Mat-desau/S7_APP1/APP/01 - SCHEMAS ET PCB/99 - WORKING COPY/Project Outputs for S7CAS-PLEIADES-CARTE-MERE_P01/P01_S7PLEIADES_ALIM.PDF

V | I | V | I | V | I
24 V | 4,6425 A | 24 V | 8 mA | 24 V | 8 mA
V I
24 V | 4,6425 A
| | V | I | V | I
| | 24 V | 1,9 A | 24 V | 1,9 A
SWR | Eff: 50 % | LDO | Eff: 83% | V | I | V | I | V | I
| | | | 5V | 56,2 mA | 5 V | 12mA | 5 V | 44.2mA
Vin | Vout | Vin | Vout
24 V | 6 V | 6 V | 5 V
Iin | Iout | Iin | Iout
28,1 mA | 56,2 mA | 56,2 mA | 56,2 mA
Pin | Pout | Pin | Pout
0,67 W | 0,34 W | 0,34 W | 0,281 W
SWR | Eff: 70 % | LDO | Eff: 63% | V | I | V | I | V | I
| | | | -5V | 56,2 mA | 5 V | 12 mA | 5 V | 44,2 mA
Vin | Vout | Vin | Vout
24 V | -8 V | -8 V | -5 V
Iin | Iout | Iin | Iout
24,4 mA | 56,2 mA | 56,2 mA | 56,2 mA
Pin | Pout | Pin | Pout
0,59 W | 0,45 W | 0,45 W | 0,281 W
SWR | Eff: 85%
Vin 24 V | Vout 5 V
Iin 0,774 A | Iout 3,16 A
Pin | Pout | V | I | V | I | V | I | 3 | I | 3 | I
18,58 W | 15,8 W | 3,3 V | 50mA | 3,3 V | 5 mA | 3,3 V | 0,33mA | 3,3 V | 0,33mA | 3,3 V | 0,25 A
SWR | Eff: 95% | V | I | V | I | V | I | V | I | V | I | V | I
| | 3,3 V | 0,96966 A | 3,3 V | 100mA | 3,3 V | 500mA | 3,3 V | 47mA | 3,3 V | 2mA | 3,3 V | 15mA
Vin | Vout
5 V | 3,3 V
Iin 1,716 A | Iout 2,47 A
Pin 8,58 W | Pout 8,1551 W | V 3,3 V | I 0,1 A | V 3,3 V | I 0,1 A
V | I | V | I | V | I | V | I | V | I | V | I
3,3 V | 0,108 A | 3,3 V | 0,1 A | 3,3 V | 2 mA | 3,3 V | 2 mA | 3,3 V | 2 mA | 3,3 V | 2 mA
V | I | V | I | V | I | V | I
3,3 V | 4,334 mA | 3,3 V | 4 mA | 3,3 V | 0,165 mA | 3,3 V | 0,165 mA
V | I | V | I
3,3 V | 0,05 A | 3,3 V | 0,05 A
LDO | Eff: 46 % | LDO | Eff: 50%
P.5 PFGA (DC switching) | p.40 Datasheet
Vin | Vout | Vin | Vout
3,3 V | 1,5V | 1,5 V | 0,75 V | V | I | V | I | V | I
Iin | Iout | Iin | Iout | 0,75 V | 41 uA | 0,75 | 40 uA | 0,75 | 1 uA
1,2477 A | 1,2477 A | 41 uA | 41 uA
Pin | Pout | Pin | Pout
4,11 | 1,872 W | 61,5 uW | 30,75 uW
Vin | Vout
1,5 V | 0,75 V | V | I | V | I
Iin | Iout | 0,75 V | 0,4477 A | 0,75 V | 0,4477 A
0,4477 A | 0,4477 A
Pin | Pout
0,671 W | 0,335 W
V | I | V | I
1,5 V | 0,2 A | 1,5 V | 0,2 A
V | I | V | I
1,5 V | 0,3 A | 1,5 V | 0,3 A
LDO | Eff: 55% | V | I | V | I | V | I
| | 3,3 V | 0,376 A | 3,3 V | 56mA | 3,3 V | 320mA
Vin | Vout
5 V | 3,3 V
Iin 0,376 A | Iout 0,376 A
Pin 1.88 W | Pout 1,2408 W
SWR | Eff: 85% | V | I | V | I
| | 1,8 V | 0,05 A | 1,8 V | 0,05 A
Vin | Vout
5 V | 1,8 V
Iin 0,26 A | Iout 0,616 A
Pin 1,3041 W | Pout 1,1088 W | V 1,8 V | I 0,058 A | V 1,8 V | I 58mA
V | I | V | I | V | I
1,8 V | 0,508 A | 1,8 V | 343mA | 1,8 V | 165mA
SWR | Eff: 82 % | V | I | V | I
| | 1,2 V | 3A | 1,2 V | 3A
Vin | Vout
5 V | 1,2 V
Iin 0,818 A | Iout 3 A
Pin 4,09 W | Pout 3,6 W

5V

P
0,281 W

-5V

P
0,281 W

3V3_MOT

P
1,1022 W

FPGA

P
30,75 uW | 225 uW

Pdis
0,335 W

VCCO_2

P
0,3564 W

Pdis
23,25 uW

VREF0V75

P

0,336 W

P

VTT0V75

VCCO_1

24V
External
Power Supply

P
111,42 W

(U3) TPS51200DRCT

0,33W | 1,65W | 0,15W | 0,007W | 0,05W
P | P | P | P | P

D5 (DEL IO) (+TVS)

P
0,0066 W

D6 (DEL IO) (+TVS)

P

3,199 W

+24V

P
111,42 W

VCCO_0

0,0066 W

D3 (DEL IO) (+TVS)

P
0,0066 W

D4 (DEL IO) (+TVS)

P
0,0066 W

0,0165 W

Y2 (Clock Osillo) | U12 (Clock Buffer) | U5 (Ethernet PHY) | J2 (LED Ethernet) | Y1 (Oscilli Ethernet)
| | 0,001W | 0,001W

M1 (JTAG)

P
0,17W
S1 (Bouton RESET) | S2 (Bouton 1) | S3 (Bouton 2)
P | P | P

0,45 W

U8D (CAN)

Calcul DDR3 (fichier)

P
0.18W | 1,06W

0,22W

U1A (FPGA) (50%+)

P
0,33 W

U1C (FPGA) (50%+)

P

U1B (MOTEUR)(ALIM)

P
0,192 W

U1C (MOTEUR)(ALIM)

P
0,192 W

U1D (FPGA)(+50%)

P
0,45 W

U2 (DDR3)

P
0,3 W
U11 (Ampli-OP) (CNA) | U9 (Ampli-OP) (CAN)

P P
0,06 W | 0,22 W

0,33 W

U11 (Ampli-OP) (CNA)

P
0,06W

U9 (Ampli-OP) (CAN)

P

1V2

P

RES (40x24)(1,5V-0,75V)

P
0,335775 W

0,165 W

P
0,165 W

RES U10A (Vref)

P
0,0005445 W

U7C (CNA)

P
0,1W

U1E (FPGA)(-50%)

P
0,09 W
U7C (CNA) | U8D (CAN)

P P
0,6W | 0,3W

U10 (MotorDrive)

CLK_1V8

P

VCCO_4

P
0,09 W

Max current: 10 A

Pdis
2,688 W

U1I (VCC_AUX)

P
0,825 W

RES U10A (DECAY)

P
0,0005445 W

P
0,0132 W

U1B (FPGA)(-50%)

P

Max current: 10 A

VCC1V5

P
0,3 W

VCCO_3

P

90 et 85% environ

80% à 90% environ

(U18) LMZ34002

Max current: 2 A

(U19) NCP59744MN1ADJTBG

Max current: 3 A

Pdis
0.64 W

0,1953 W

Max current: 6 A

Pdis
0.429 W

(U17) PTH08T231W

Pdis
0,14 W

Max current: 6 A

Pdis

(U15) PTH08T231W

0,06 W

(U16) PTH08T241W

Max current: 10 A

Pdis
0,488 W

3,6 W

ANA_3V3 | U7C (CNA)

(U14) NCP59744MN1ADJTBG

Max current: 3 A

Pdis
2,24 W

3,6 W

0,1044 W

DIG_1V8

P
0,9144 W

P
0,33 W

3V3

P

P P
1,2408 W

DDR3

P
0,75 uW

PROTECTIONS

U1I (FPGA)

P

(U20) TPS7A33

Max current: 1 A

Pdis
0,17 W
MOTEUR 1 ALIM | MOTEUR 2 ALIM

P P
45,6 W | 45,6 W

(U22) LMZ23603

Max current: 3 A

Pdis
0,33 W

(U21) LMZ23610

(U25) TPS7A4701

Max current: 1 A

Pdis
