Mat-desau/S7_APP1/APP/01 - SCHEMAS ET PCB/99 - WORKING COPY/Project Outputs for S7CAS-PLEIADES-CARTE-MERE_P01/P01_S7PLEIADES_SCH.PDF

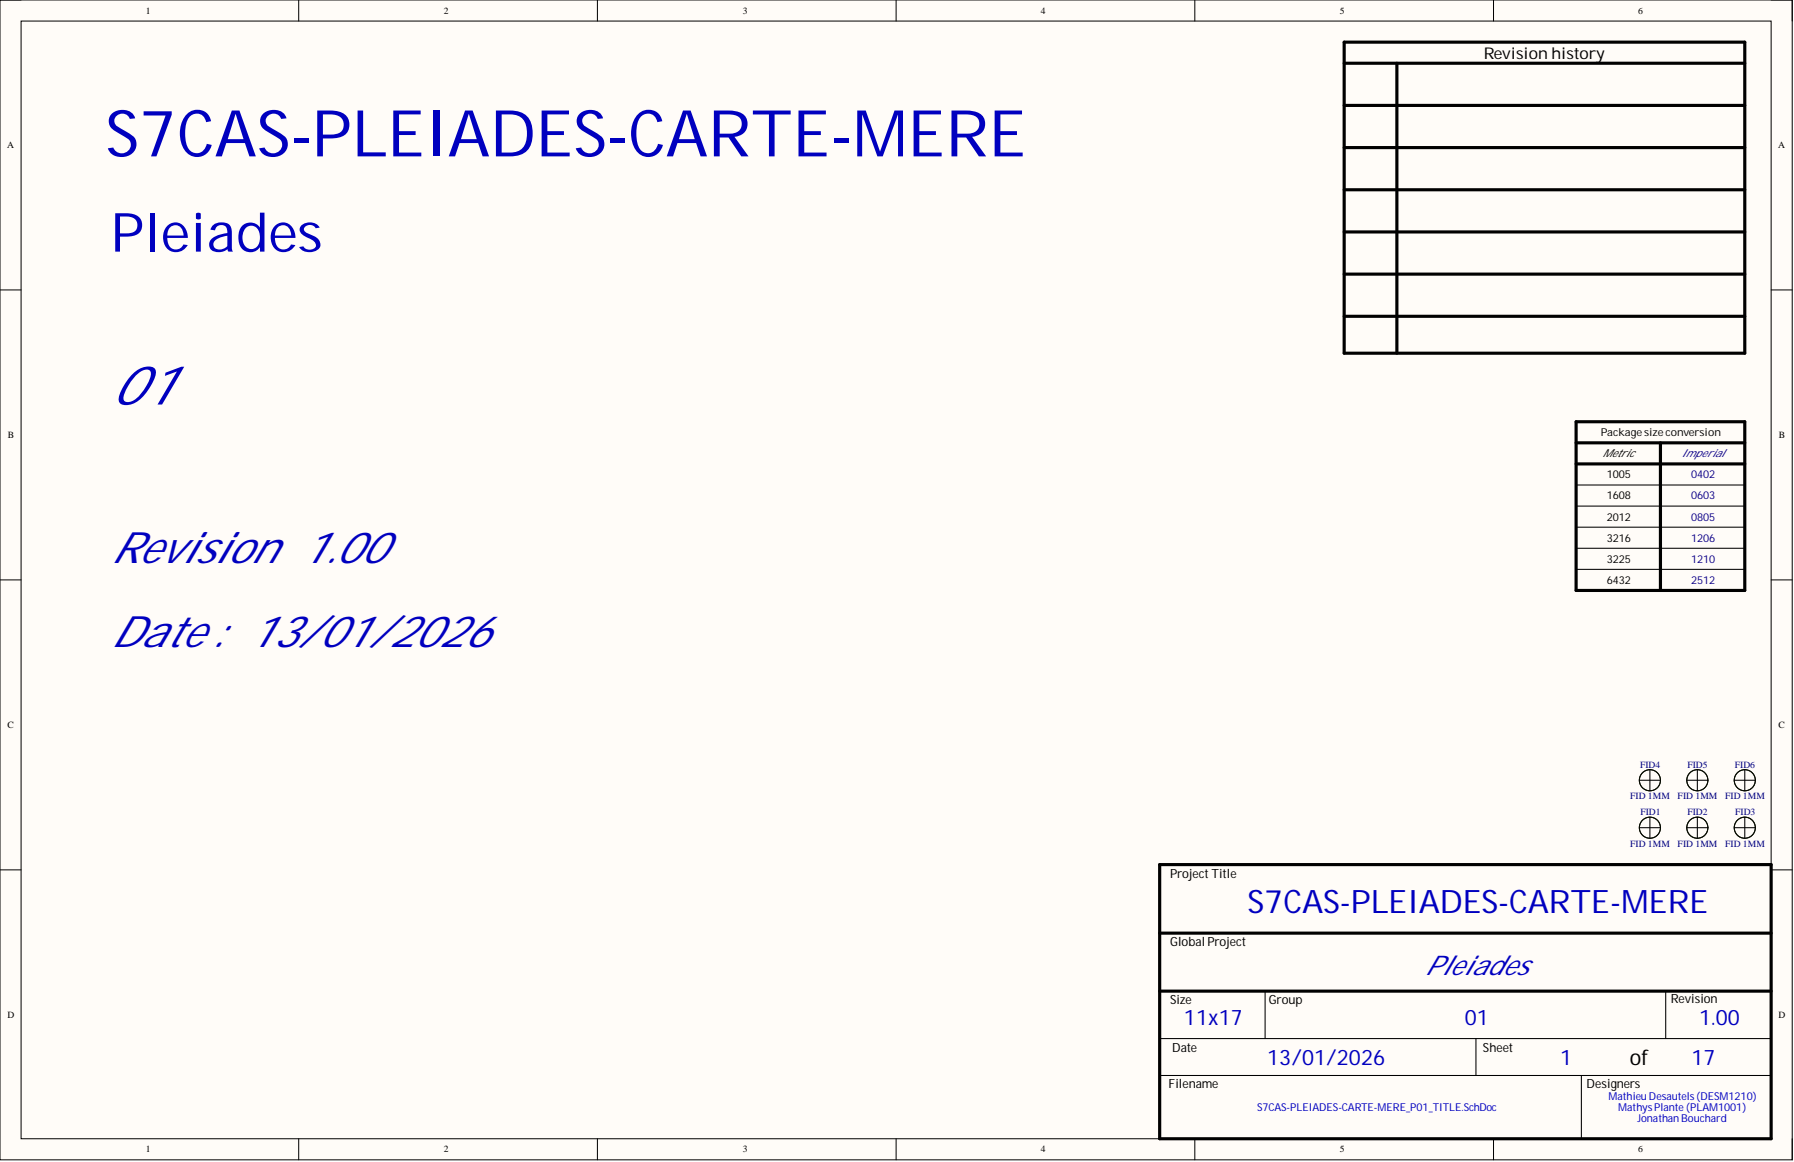
[picture p1: page 1]

Metric | Imperial

Size 11x17 | Group 01 | Revision 1.00

Date 13/01/2026 | Sheet 1 of 17

Filename S7CAS-PLEIADES-CARTE-MERE_P01_TITLE.SchDoc | Designers Mathieu Desautels (DESM1210) Mathys Plante (PLAM1001) Jonathan Bouchard

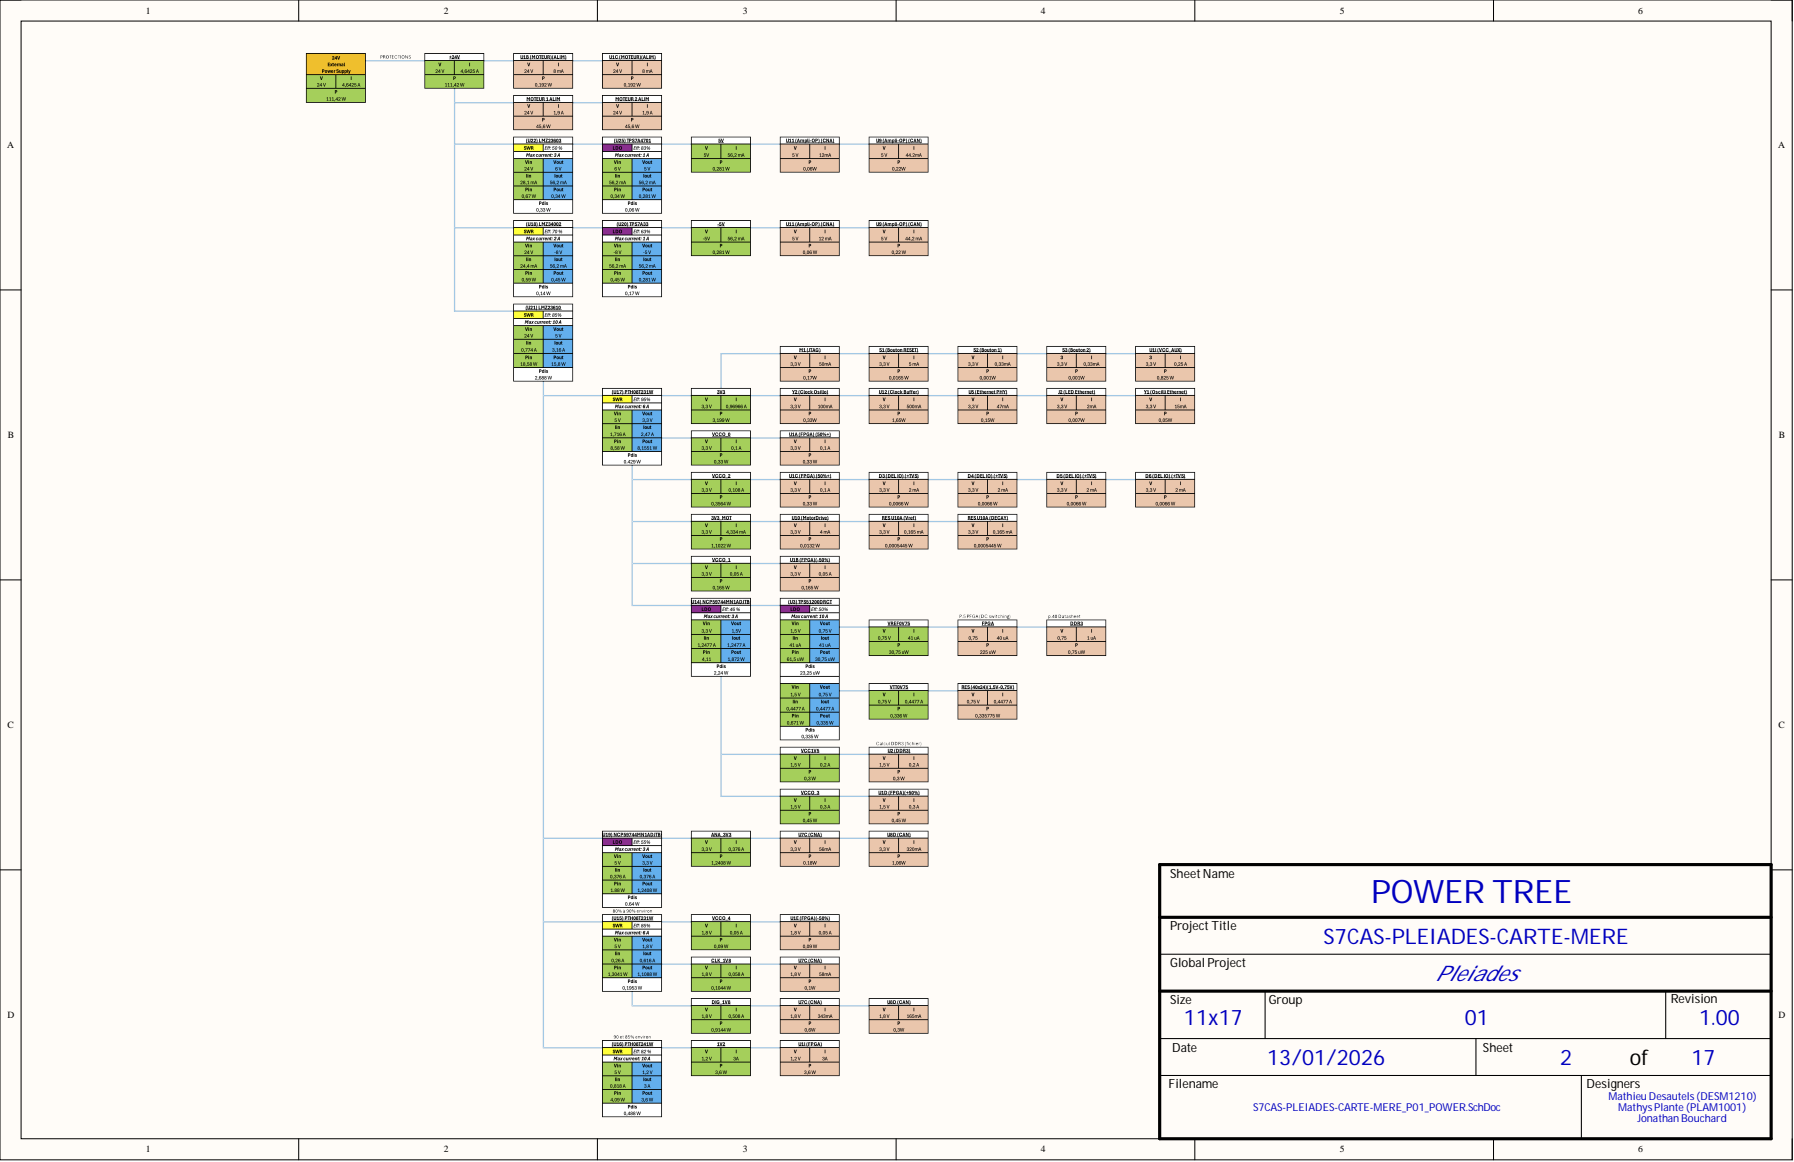
[picture p2: page 2]

Size 11x17 | Group 01 | Revision 1.00

Date 13/01/2026 | Sheet 2 of 17

S7CAS-PLEIADES-CARTE-MERE_P01_POWER.SchDoc | Mathieu Desautels (DESM1210)

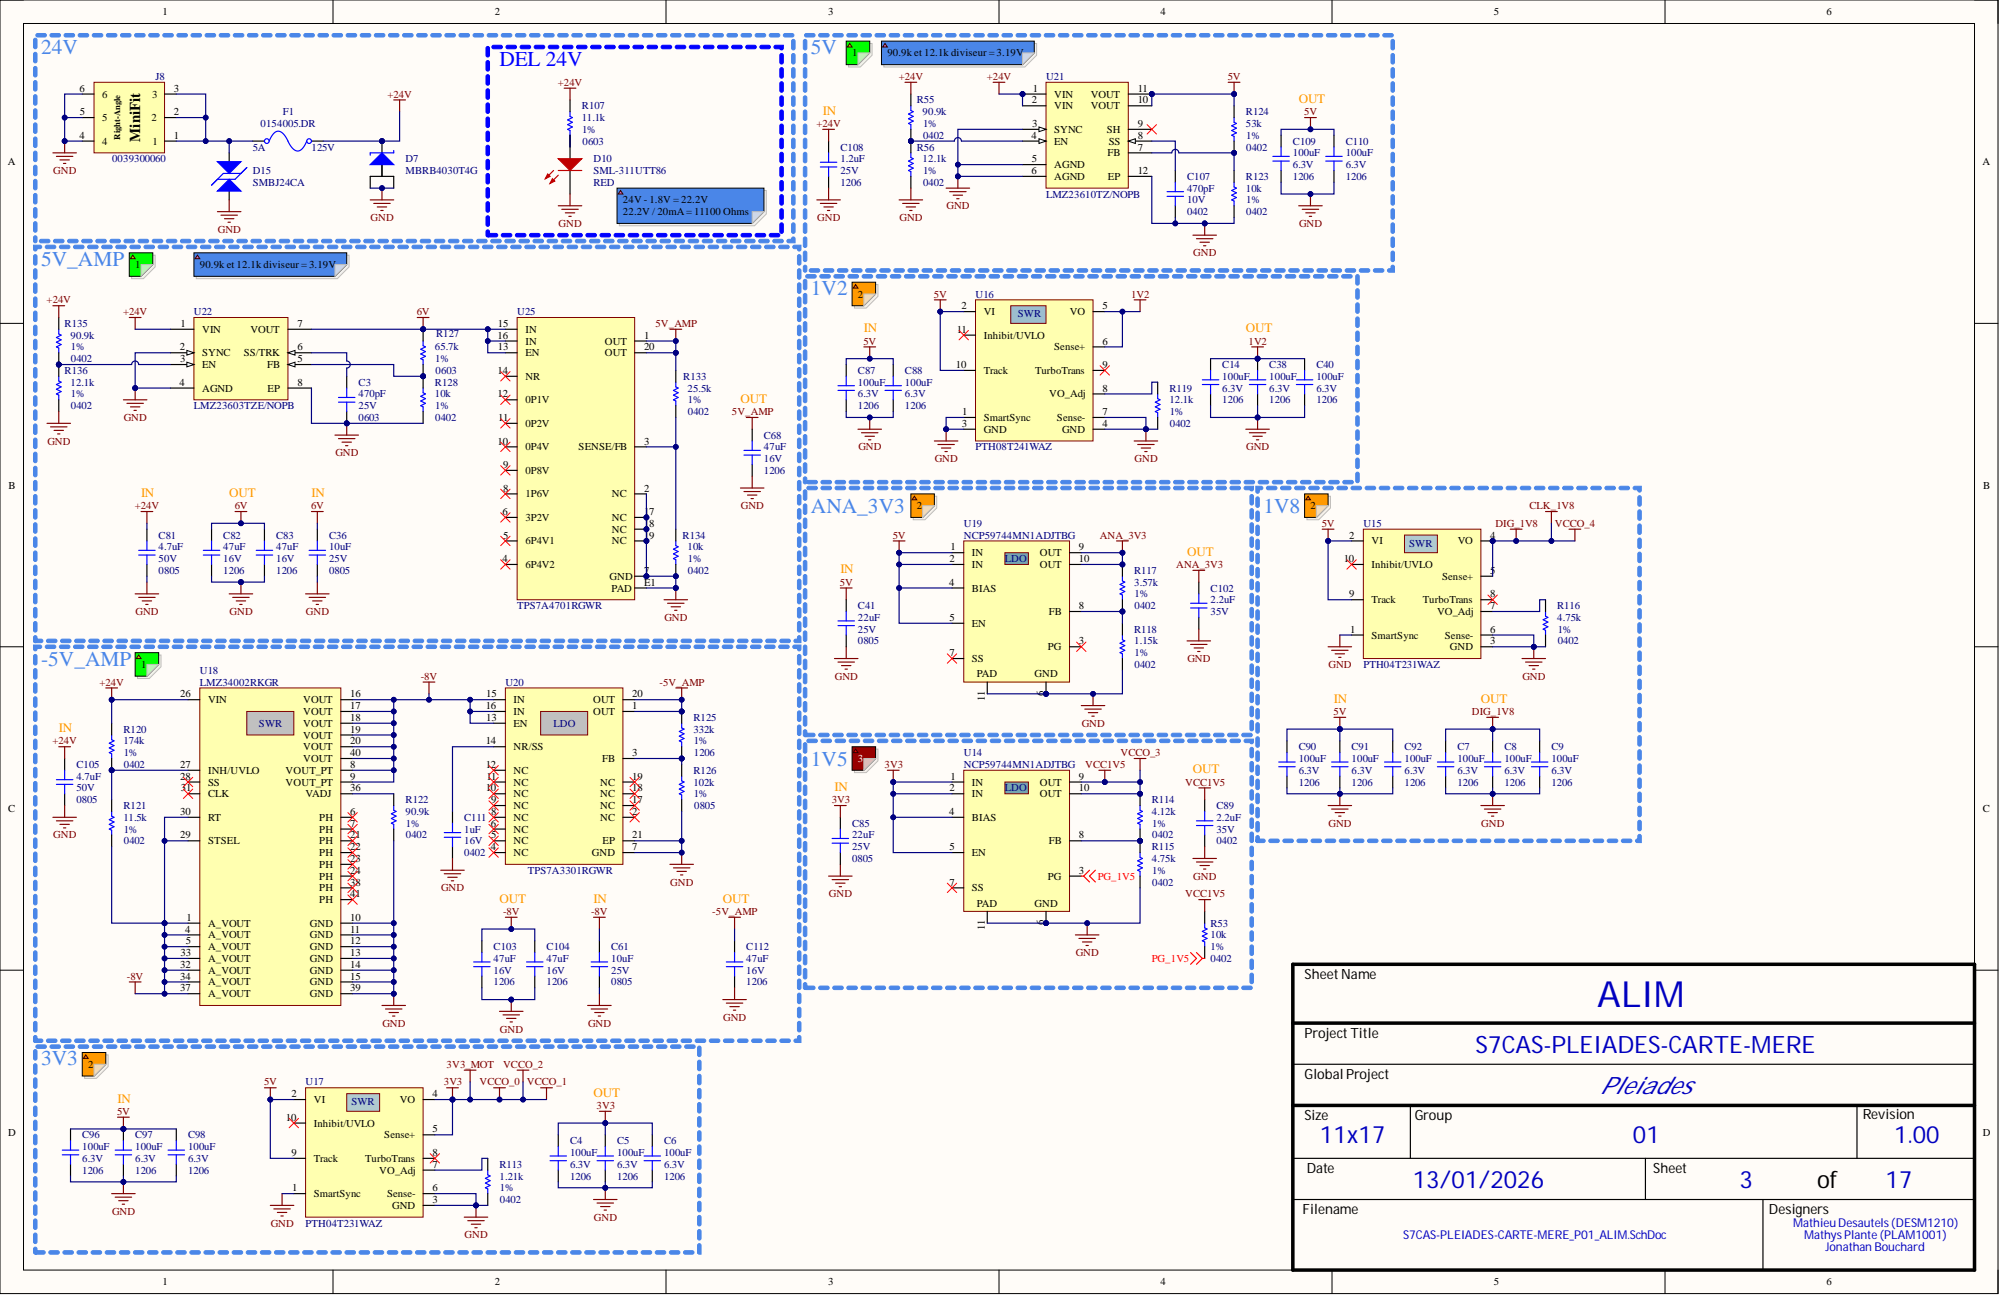
[picture p3: page 3]

AGND 5

Inhibit/UVLO 11

AGND 4

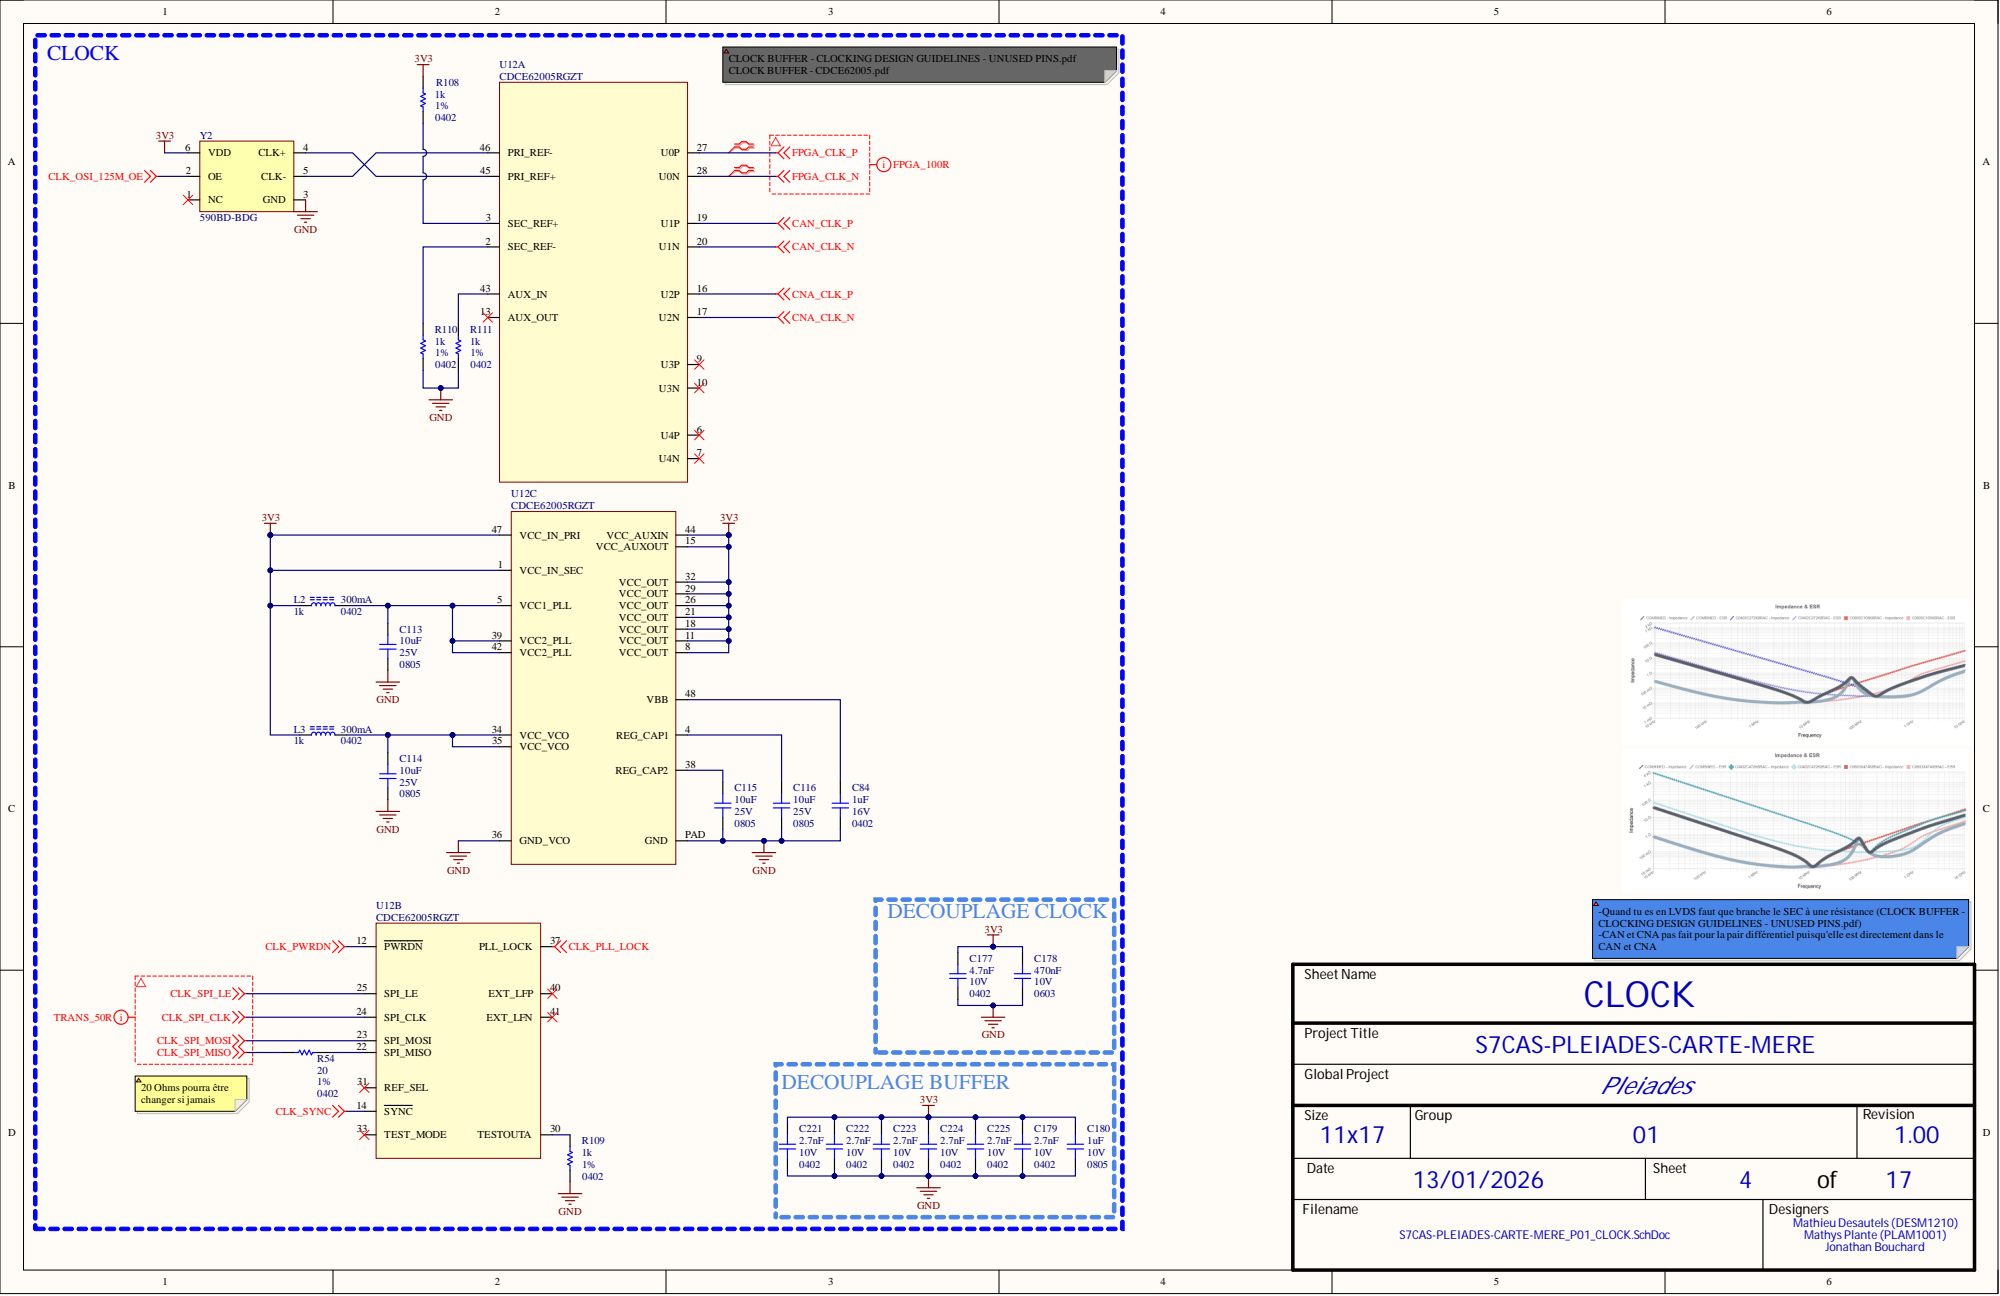
[picture p4: page 4]

CLOCK BUFFER - CLOCKING DESIGN GUIDELINES - UNUSED PINS.pdf
CLOCK BUFFER - CDCE62005.pdf

300mA | VCC1_PLL 5

VCC2_PLL 39

-Quand tu es en LVDS faut que branche le SEC à une résistance (CLOCK BUFFER -
CLOCKING DESIGN GUIDELINES - UNUSED PINS.pdf)
-CAN et CNA pas fait pour la pair différentiel puisqu'elle est directement dans le
CAN et CNA
CLOCK

Size 11x17 | Group 01 | Revision 1.00

Date 13/01/2026 | Sheet 4 of 17

S7CAS-PLEIADES-CARTE-MERE_P01_CLOCK.SchDoc | Mathieu Desautels (DESM1210)

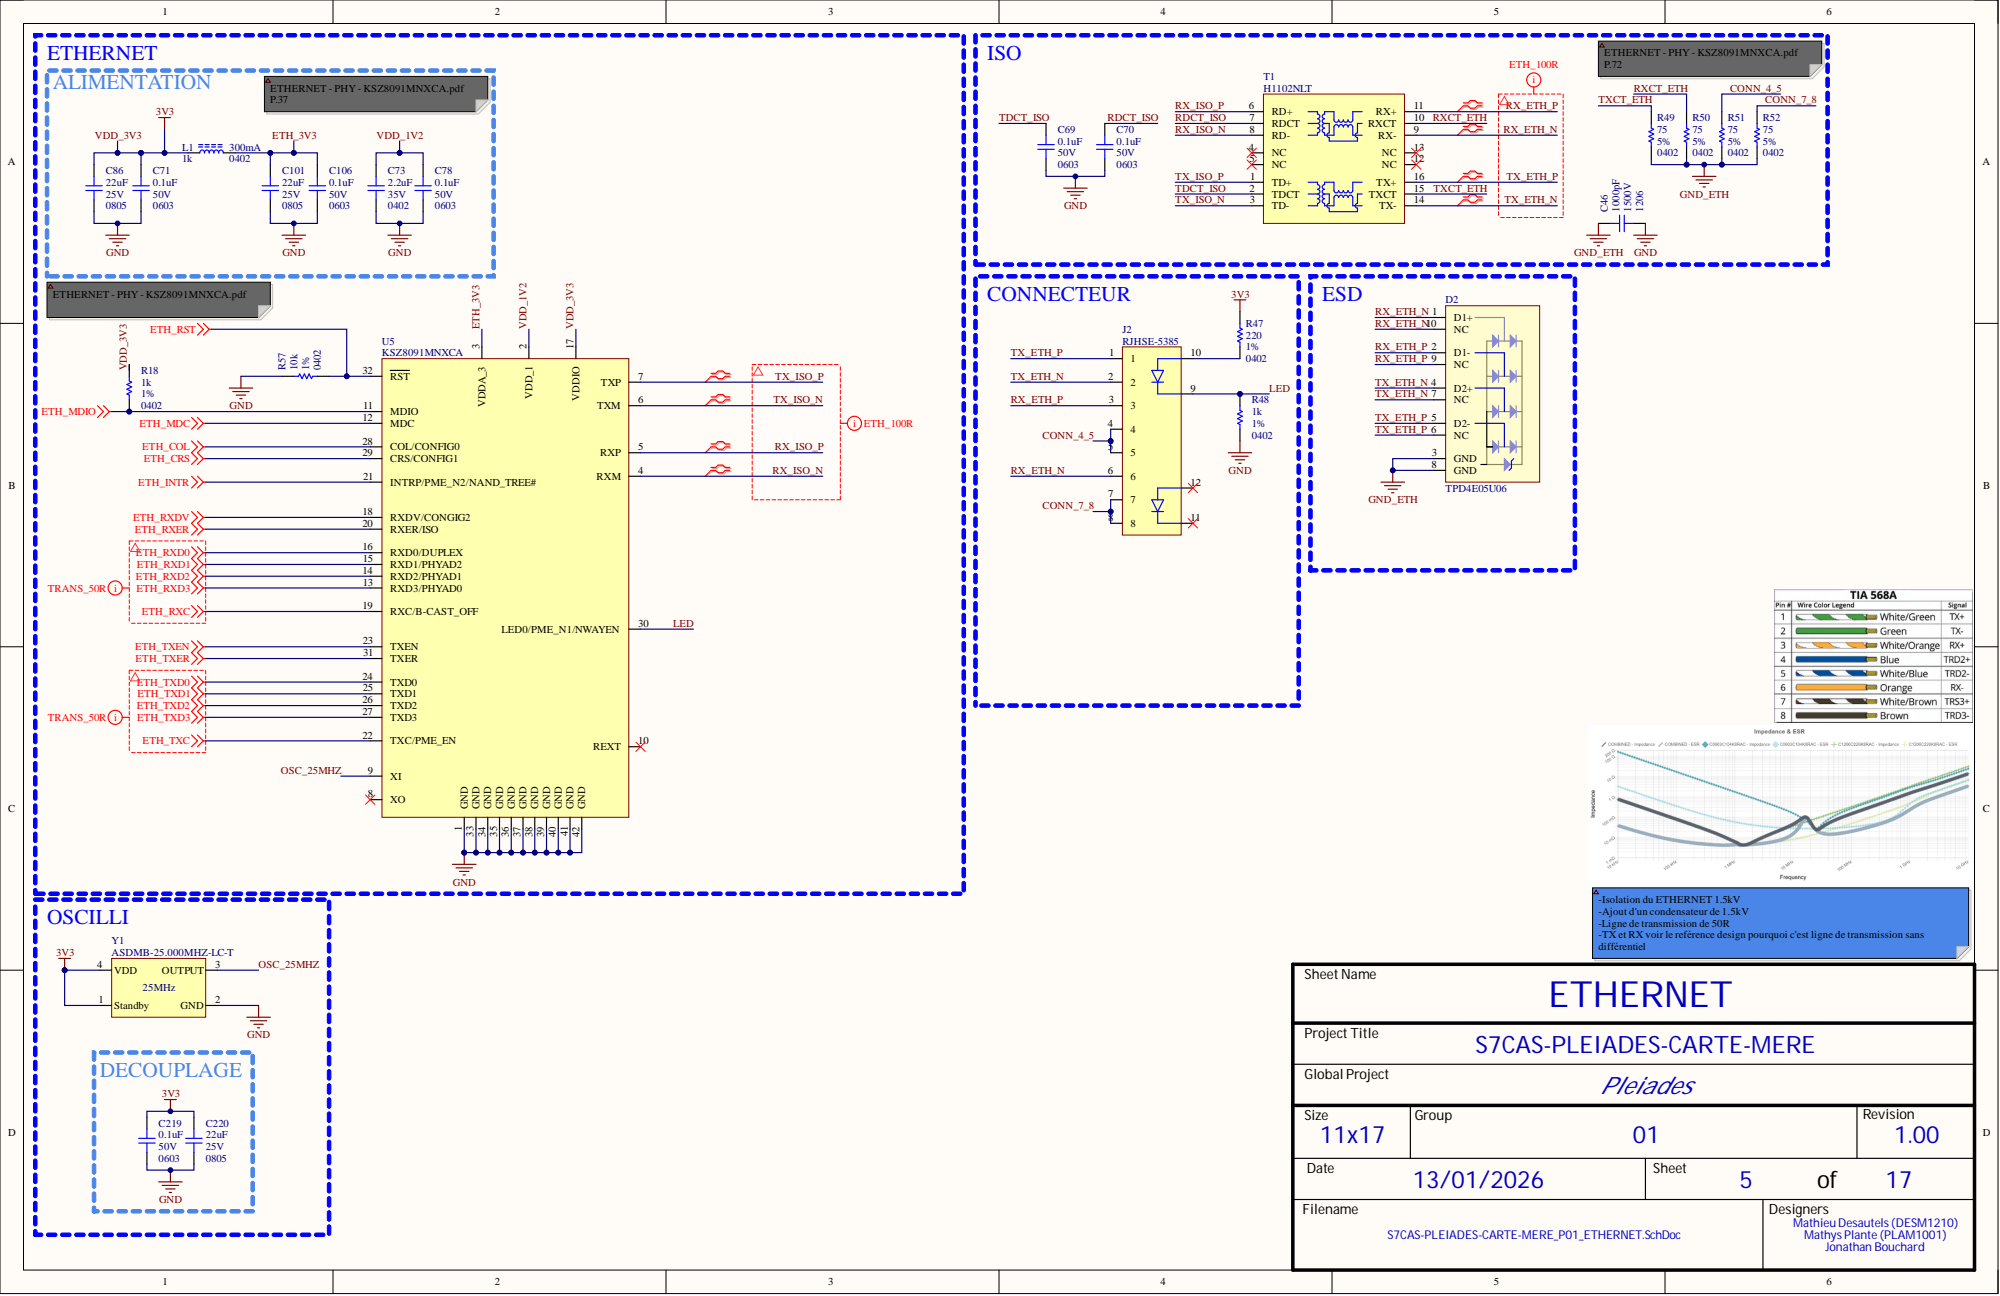
[picture p5: page 5]

-Isolation du ETHERNET 1.5kV
-Ajout d'un condensateur de 1.5kV
-Ligne de transmission de 50R
-TX et RX voir le reférence design pourquoi c'est ligne de transmission sans
différentiel
ETHERNET

Size 11x17 | Group 01 | Revision 1.00

Date 13/01/2026 | Sheet 5 of 17

S7CAS-PLEIADES-CARTE-MERE_P01_ETHERNET.SchDoc | Mathieu Desautels (DESM1210)

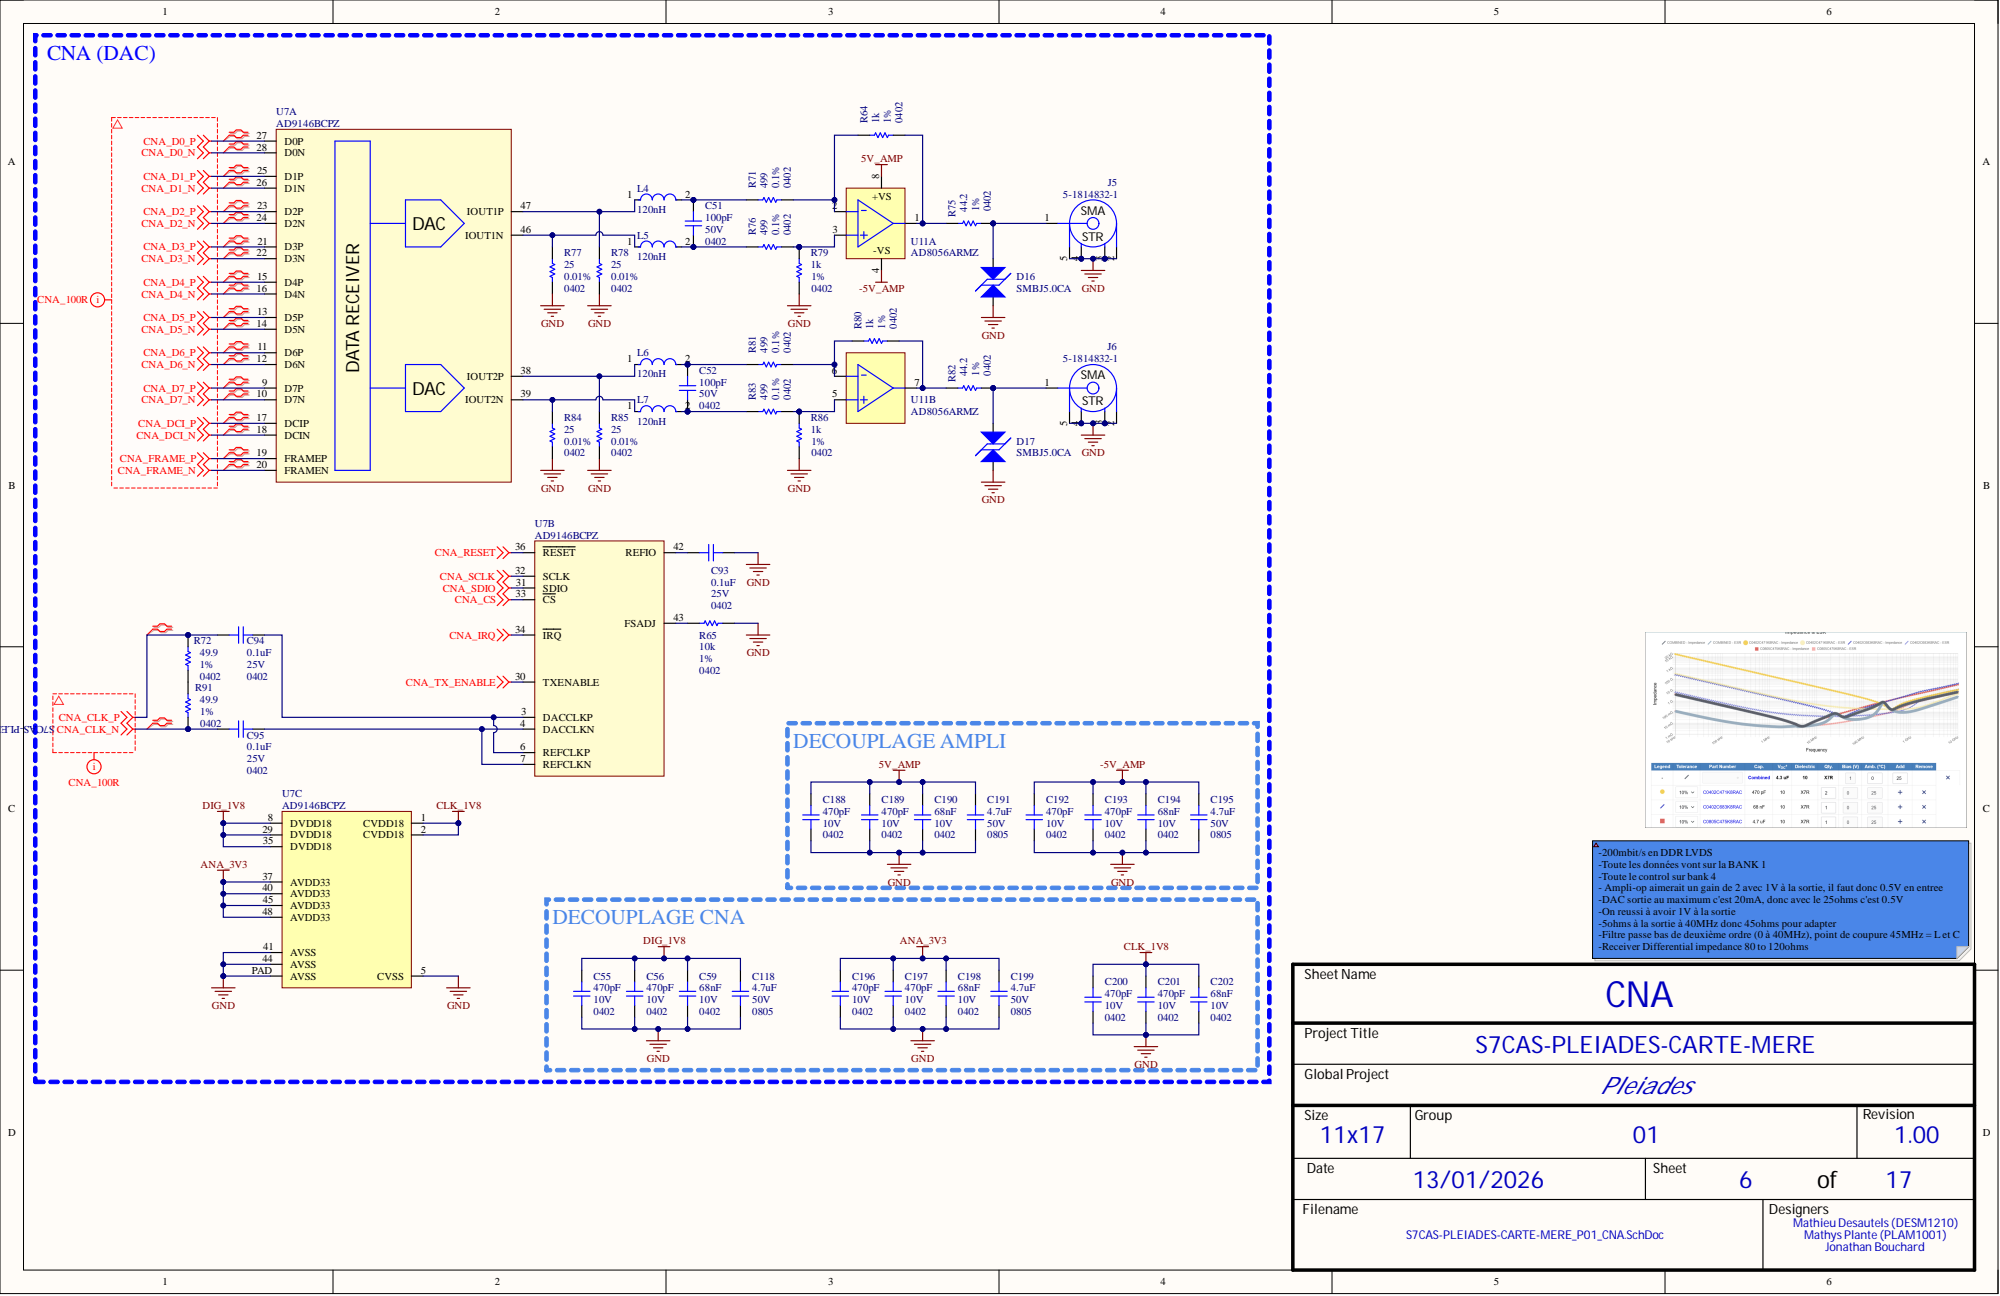
[picture p6: page 6]

0402 | | DACCLKN 4

REFCLKP 6

-200mbit/s en DDR LVDS
-Toute les données vont sur la BANK 1
-Toute le control sur bank 4
- Ampli-op aimerait un gain de 2 avec 1V à la sortie, il faut donc 0.5V en entree
-DAC sortie au maximum c'est 20mA, donc avec le 25ohms c'est 0.5V
-On reussi à avoir 1V à la sortie
-5ohms à la sortie à 40MHz donc 45ohms pour adapter
-Filtre passe bas de deuxième ordre (0 à 40MHz), point de coupure 45MHz = L et C
-Receiver Differential impedance 80 to 120ohms
CNA

AVDD33 40
AVDD33 45
AVDD33 48

Size 11x17 | Group 01 | Revision 1.00

Date 13/01/2026 | Sheet 6 of 17

S7CAS-PLEIADES-CARTE-MERE_P01_CNA.SchDoc | Mathieu Desautels (DESM1210)

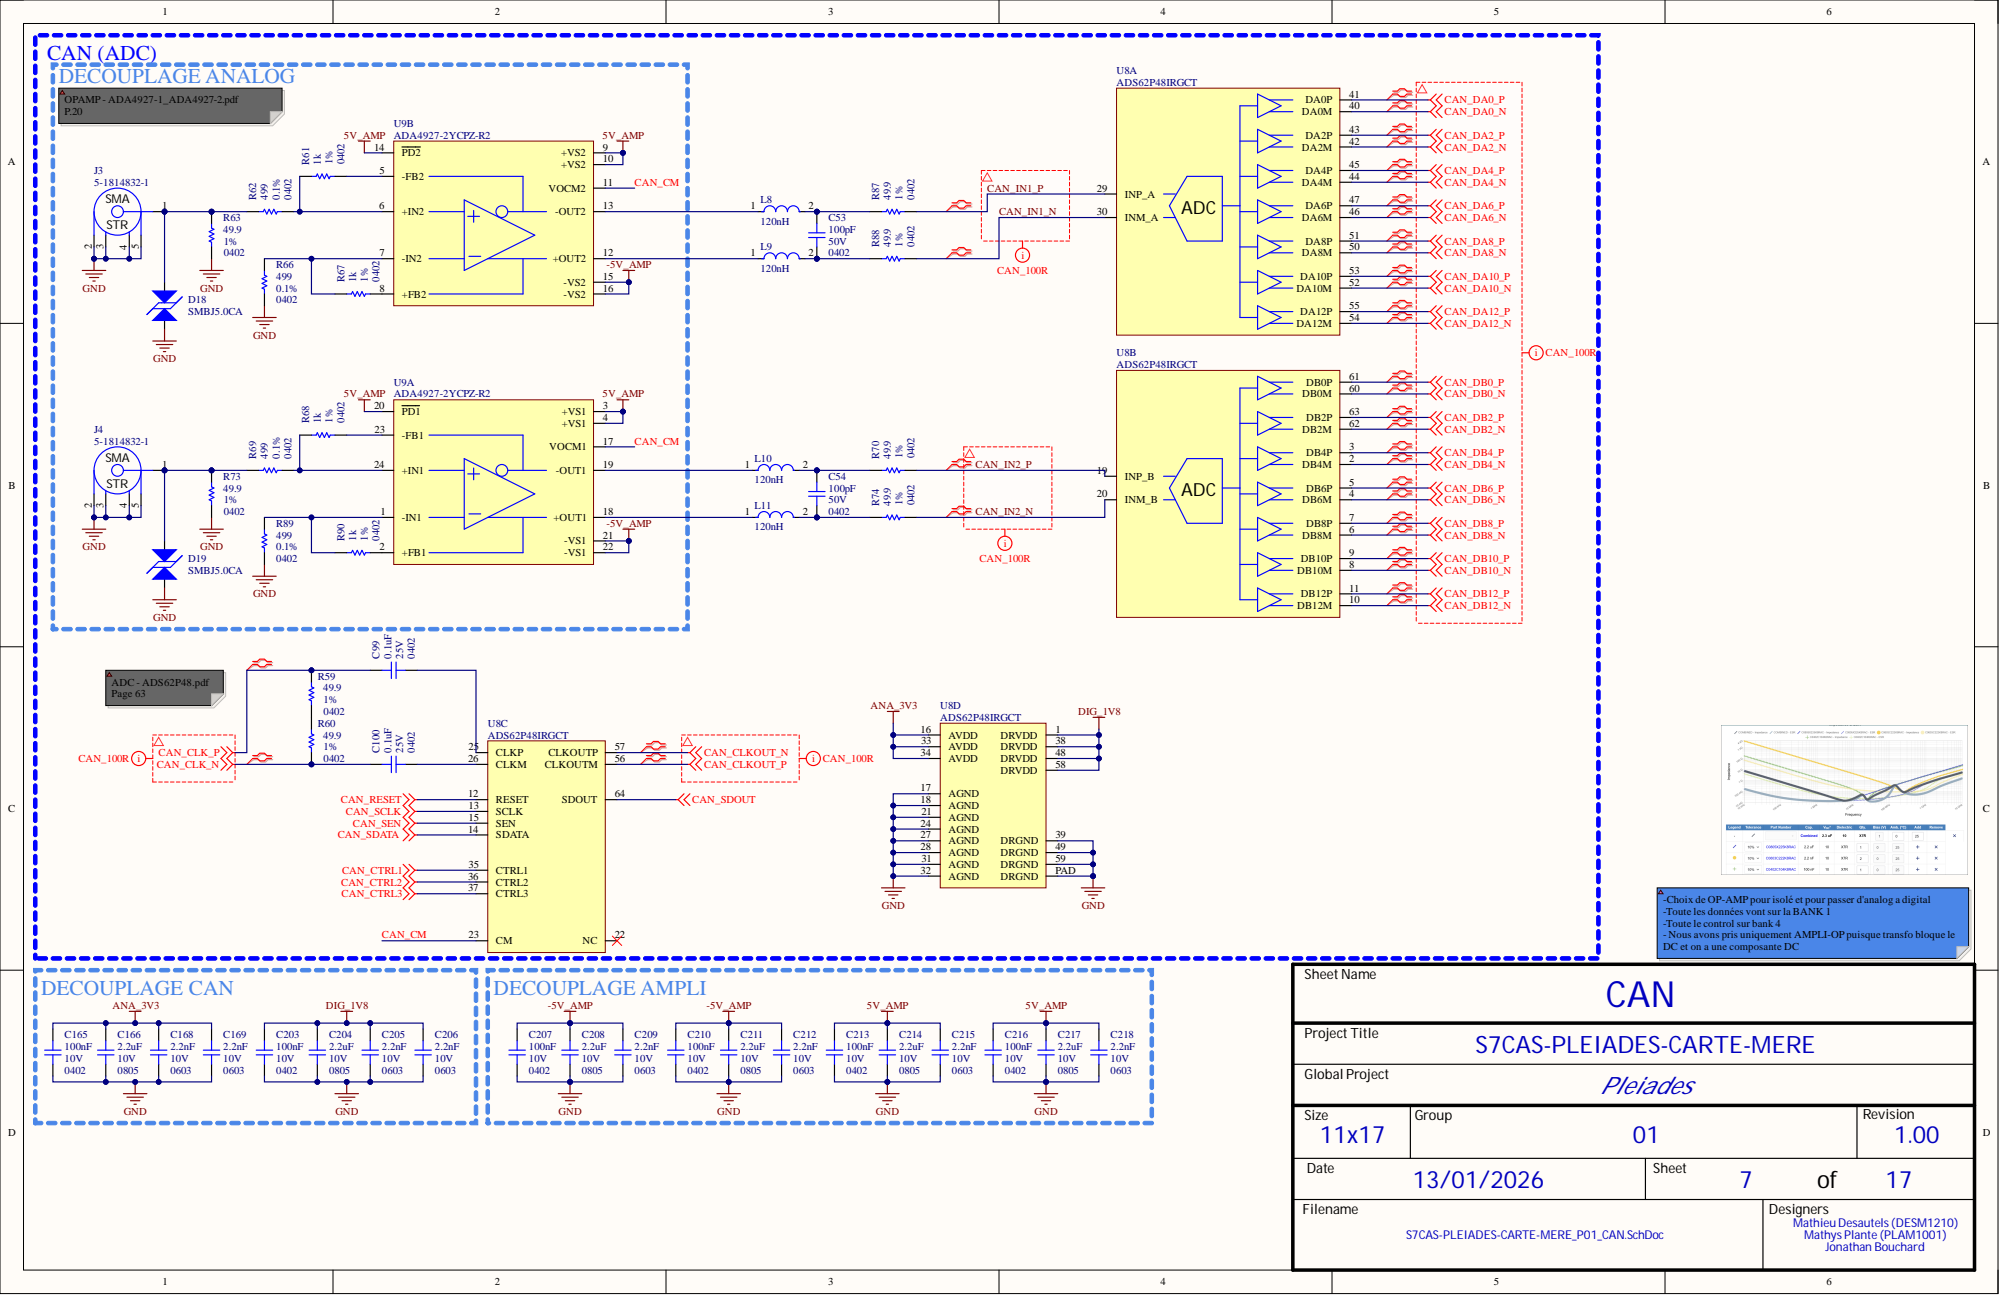
[picture p7: page 7]

INP_A 29

CAN_IN1_N | INM_A 30

INP_B 19

CAN_IN2_N

0402 | CLKM 26

-Choix de OP-AMP pour isolé et pour passer d'analog a digital
-Toute les données vont sur la BANK 1
-Toute le control sur bank 4
- Nous avons pris uniquement AMPLI-OP puisque transfo bloque le
DC et on a une composante DC
CAN

Size 11x17 | Group 01 | Revision 1.00

Date 13/01/2026 | Sheet 7 of 17

S7CAS-PLEIADES-CARTE-MERE_P01_CAN.SchDoc | Mathieu Desautels (DESM1210)

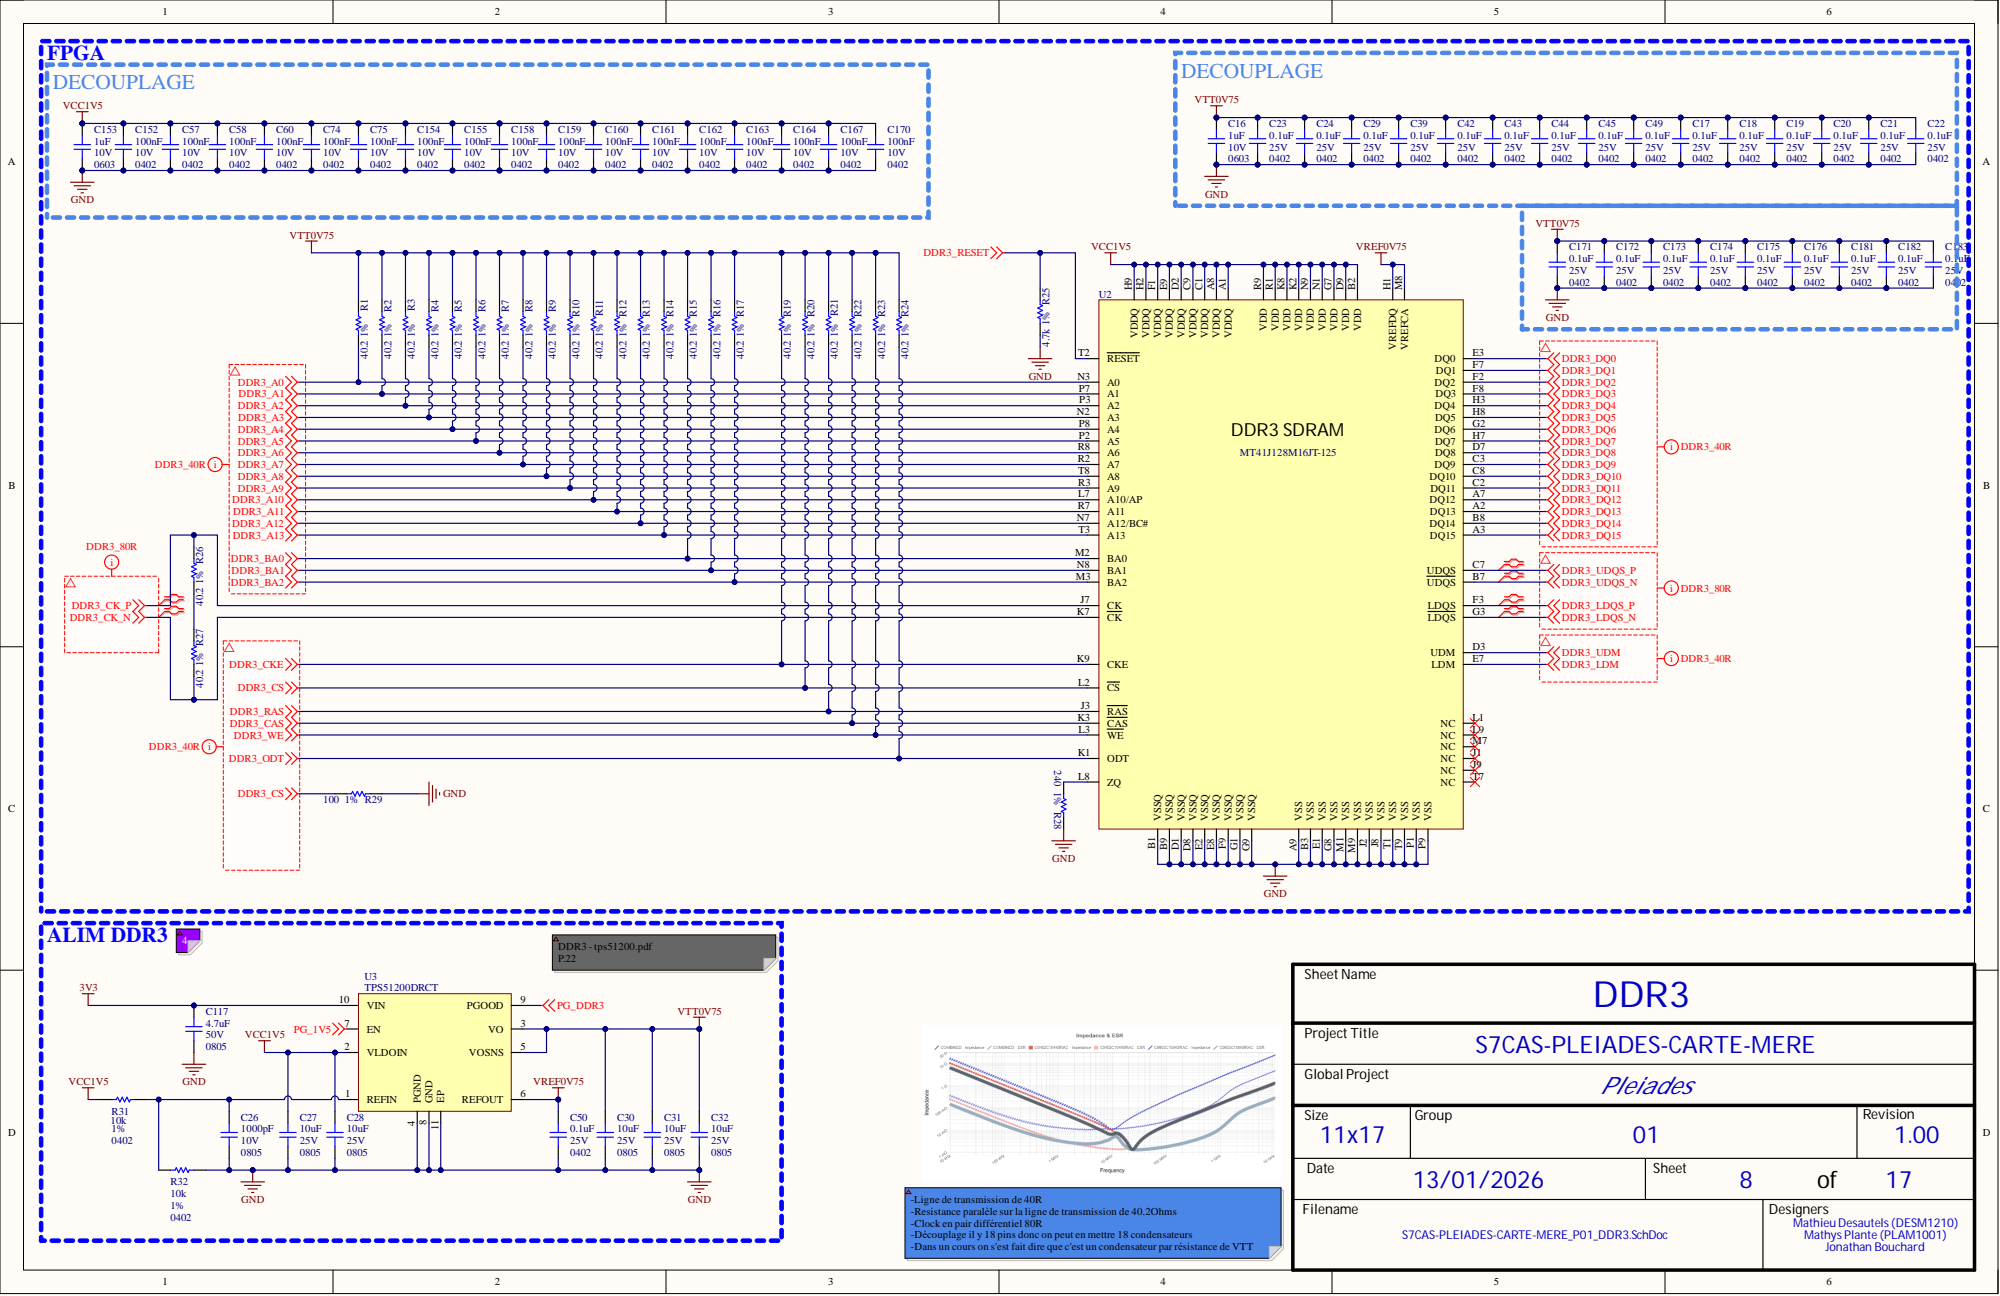
[picture p8: page 8]

A8 T8
A9 R3

DDR3_BA0 DDR3_BA1 DDR3_BA2 | BA0 M2

BA1 N8
BA2 M3

CKE K9

RAS J3

REFIN 1

Size 11x17 | Group 01 | Revision 1.00

Date 13/01/2026 | Sheet 8 of 17

-Ligne de transmission de 40R
-Resistance paralèle sur la ligne de transmission de 40.2Ohms
-Clock en pair différentiel 80R
-Découplage il y 18 pins donc on peut en mettre 18 condensateurs
-Dans un cours on s'est fait dire que c'est un condensateur par résistance de VTT

S7CAS-PLEIADES-CARTE-MERE_P01_DDR3.SchDoc | Mathieu Desautels (DESM1210)

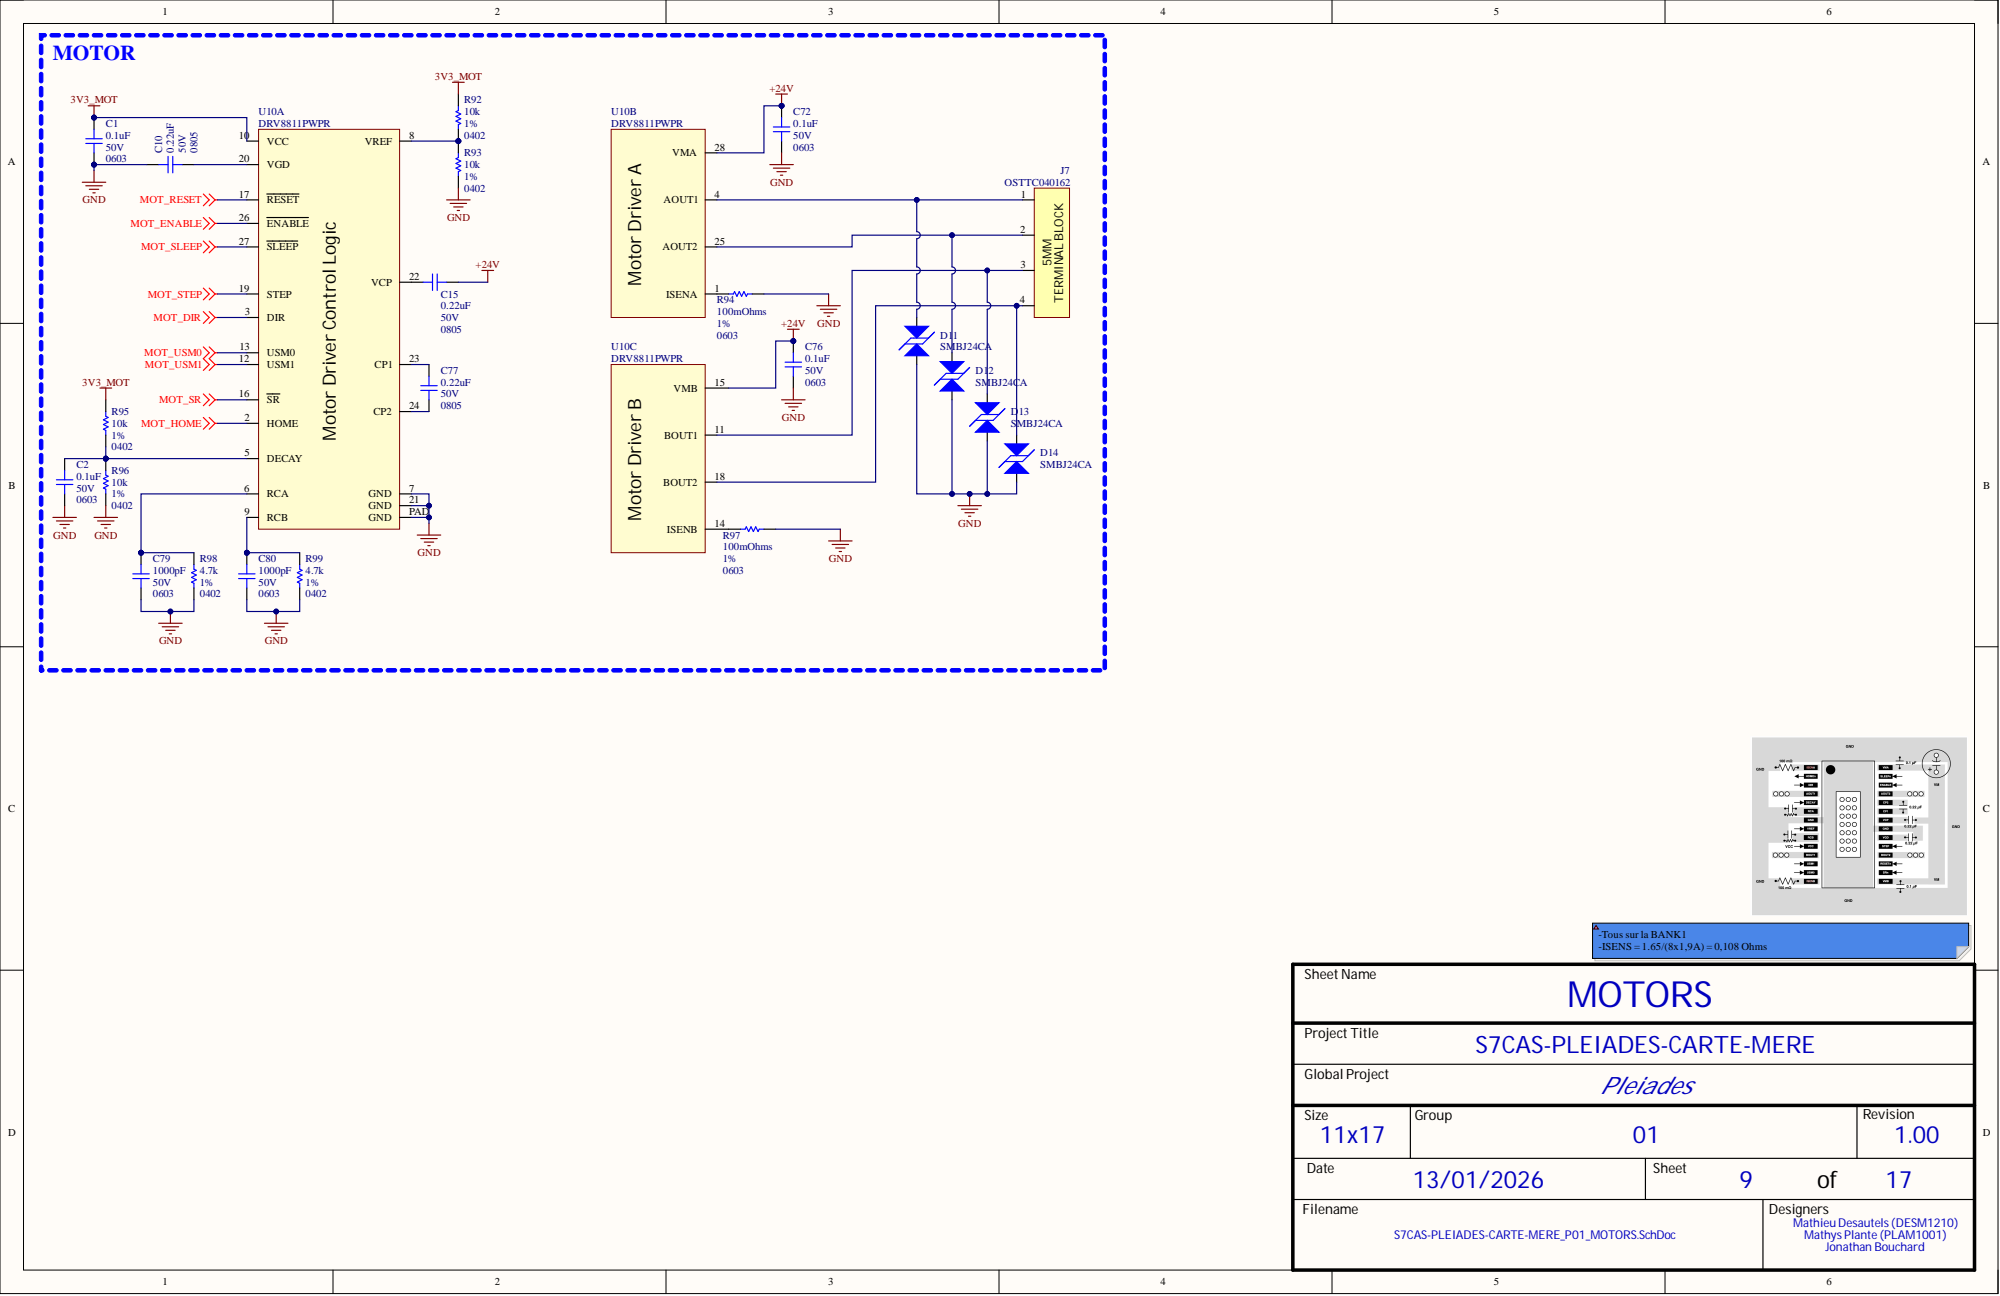
[picture p9: page 9]

Motor Driver Control Logic

Siz e 11x17 | Group 01 | R evisio n 1.00

Da te 13/01/2026 | She e t 9 of 17

Filena m e oc S7CA S-P LEIA DES-CA R TE-MERE_P01_MOTORS . Sch D | De sign r s Mathieu Desautel s (DESM1210) Mat h y P lante (P L AM1001) J onathan Bouchard

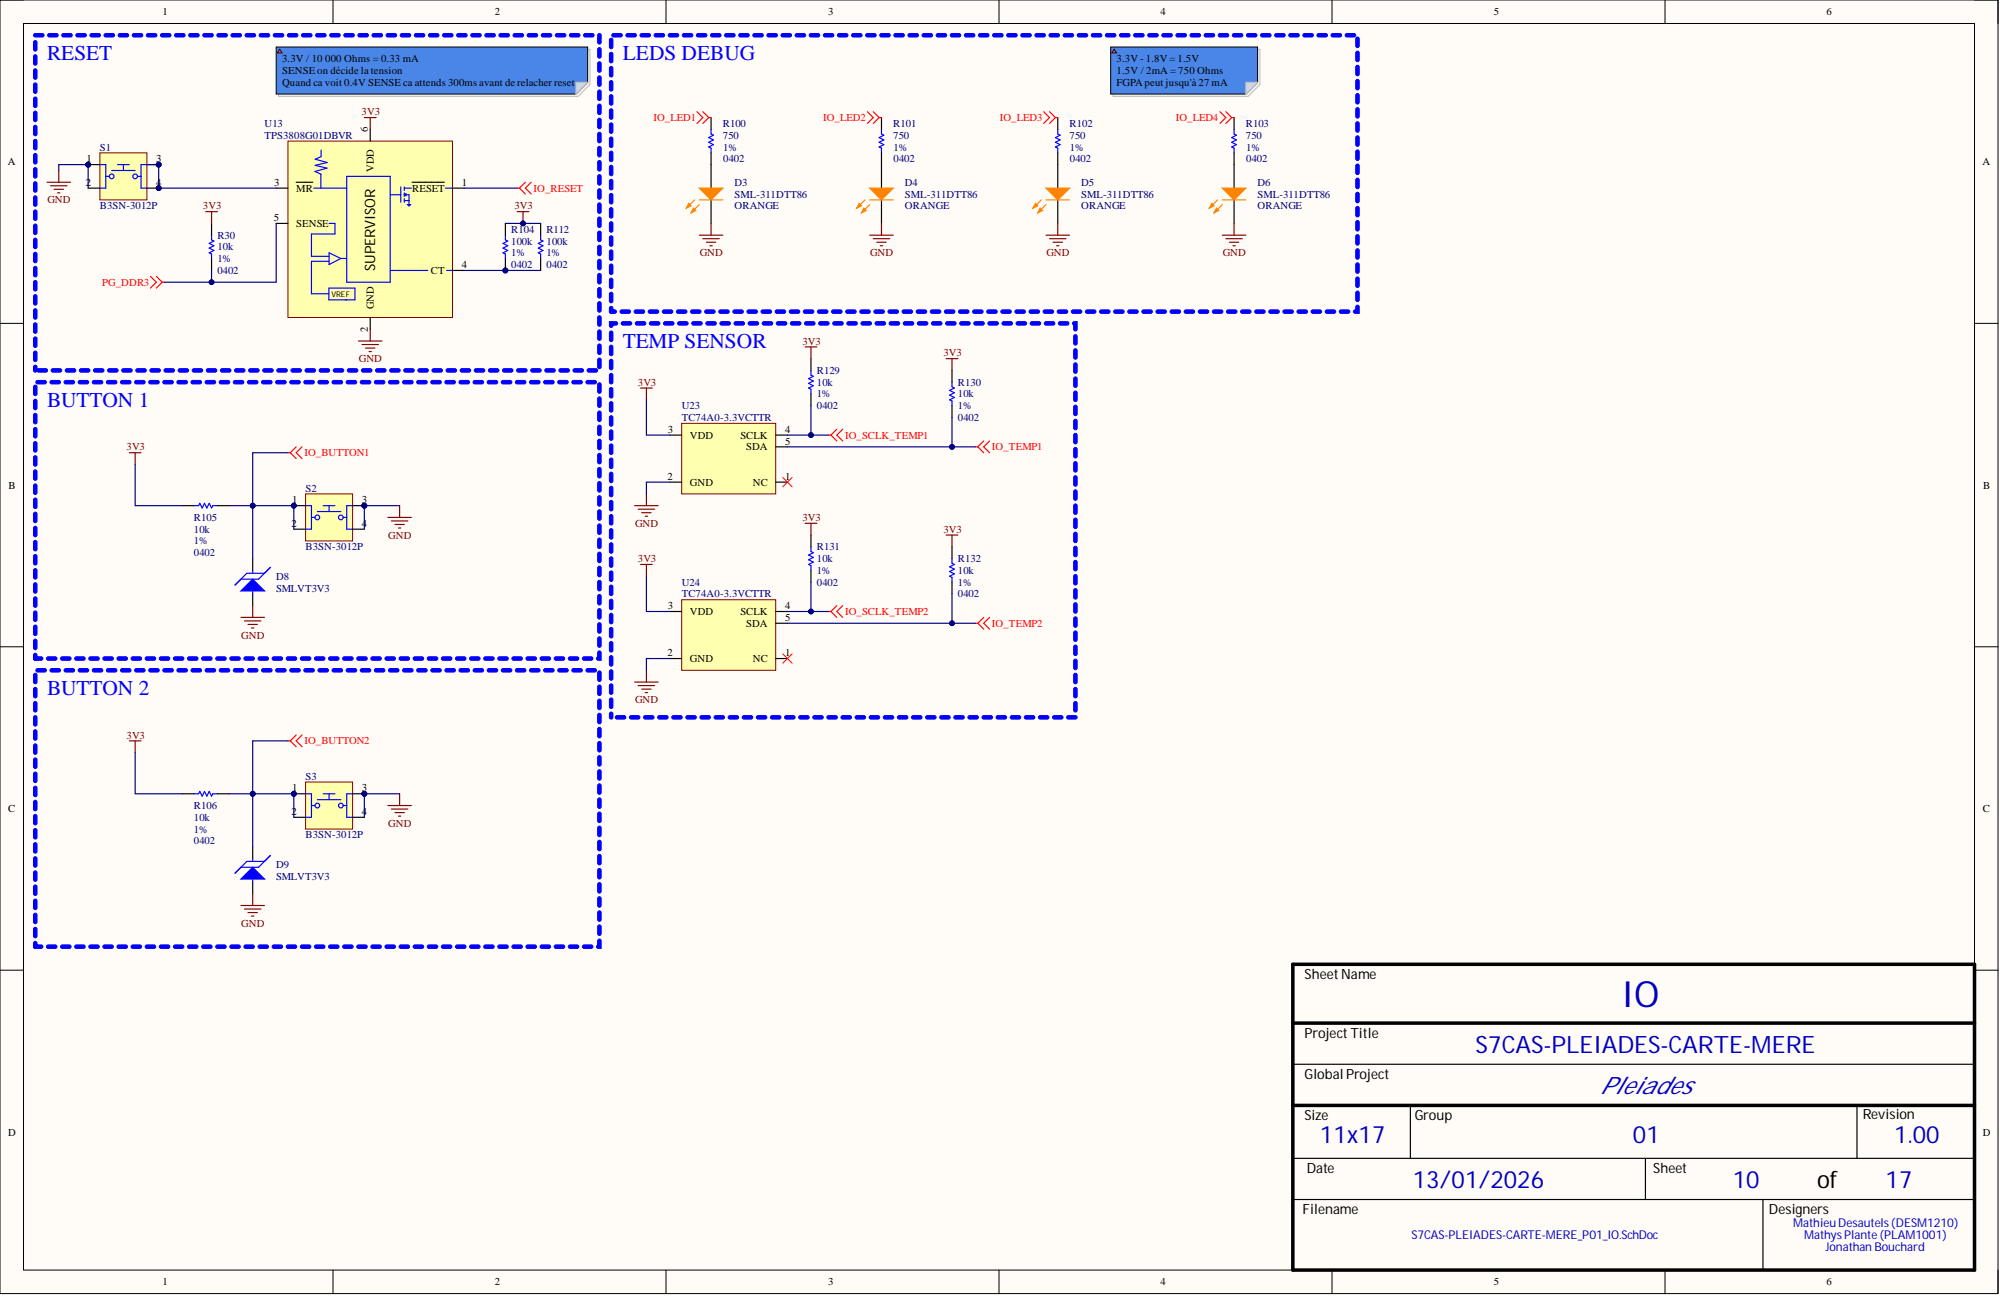
[picture p10: page 10]

Siz e 11x17 | Group 01 | R evisio n 1.00

Da te | She e t 10 of 17

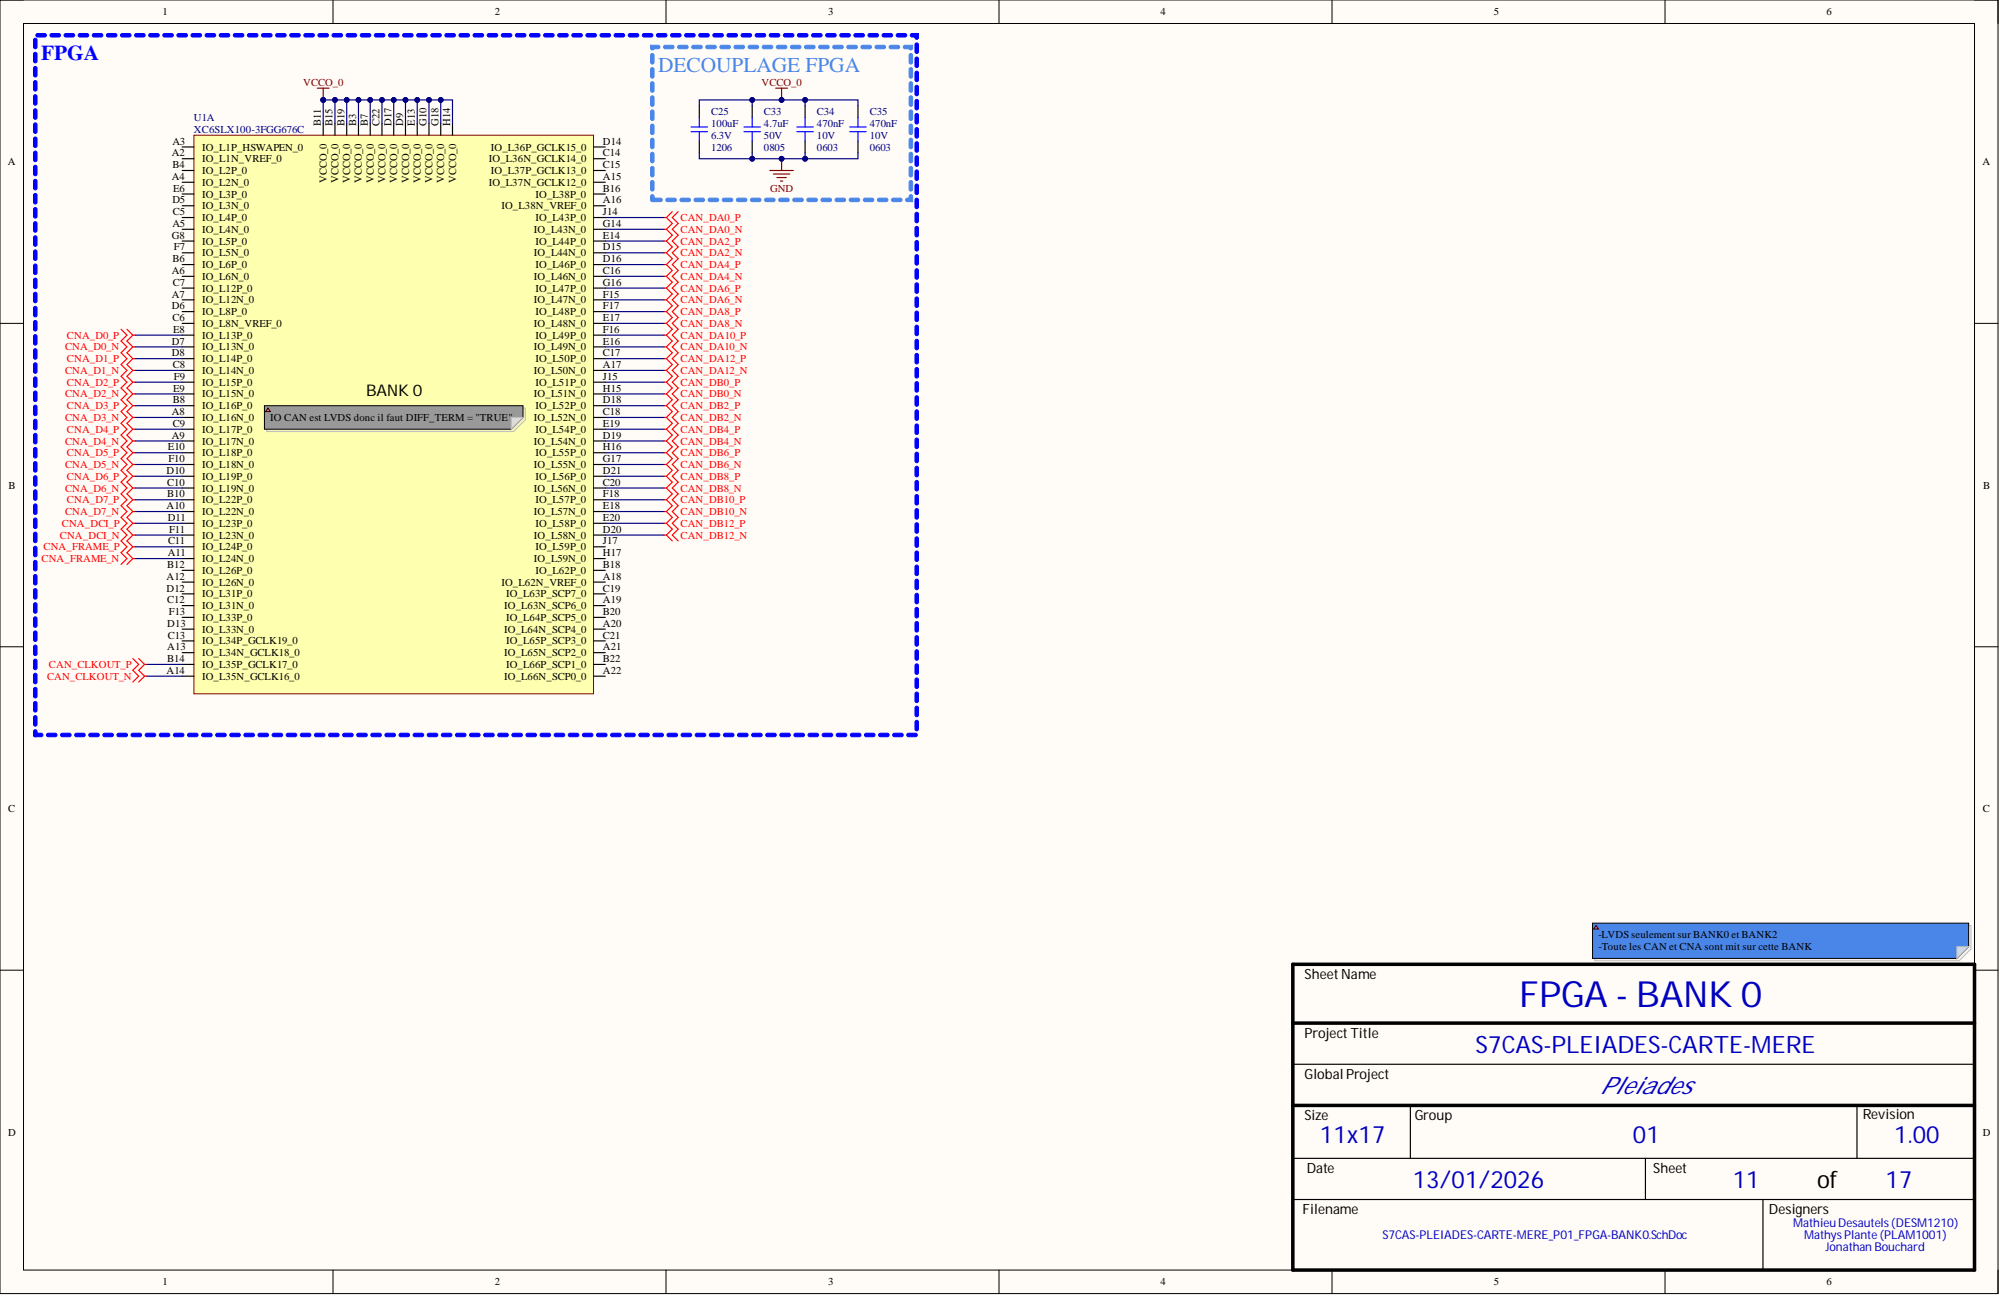
[picture p11: page 11]

Siz e 11x17 | Group 01 | R evisio n 1.00

Da te 13/01/2026 | She e t 11 of 17

TE-MERE_P01_F PGA-BANK0.

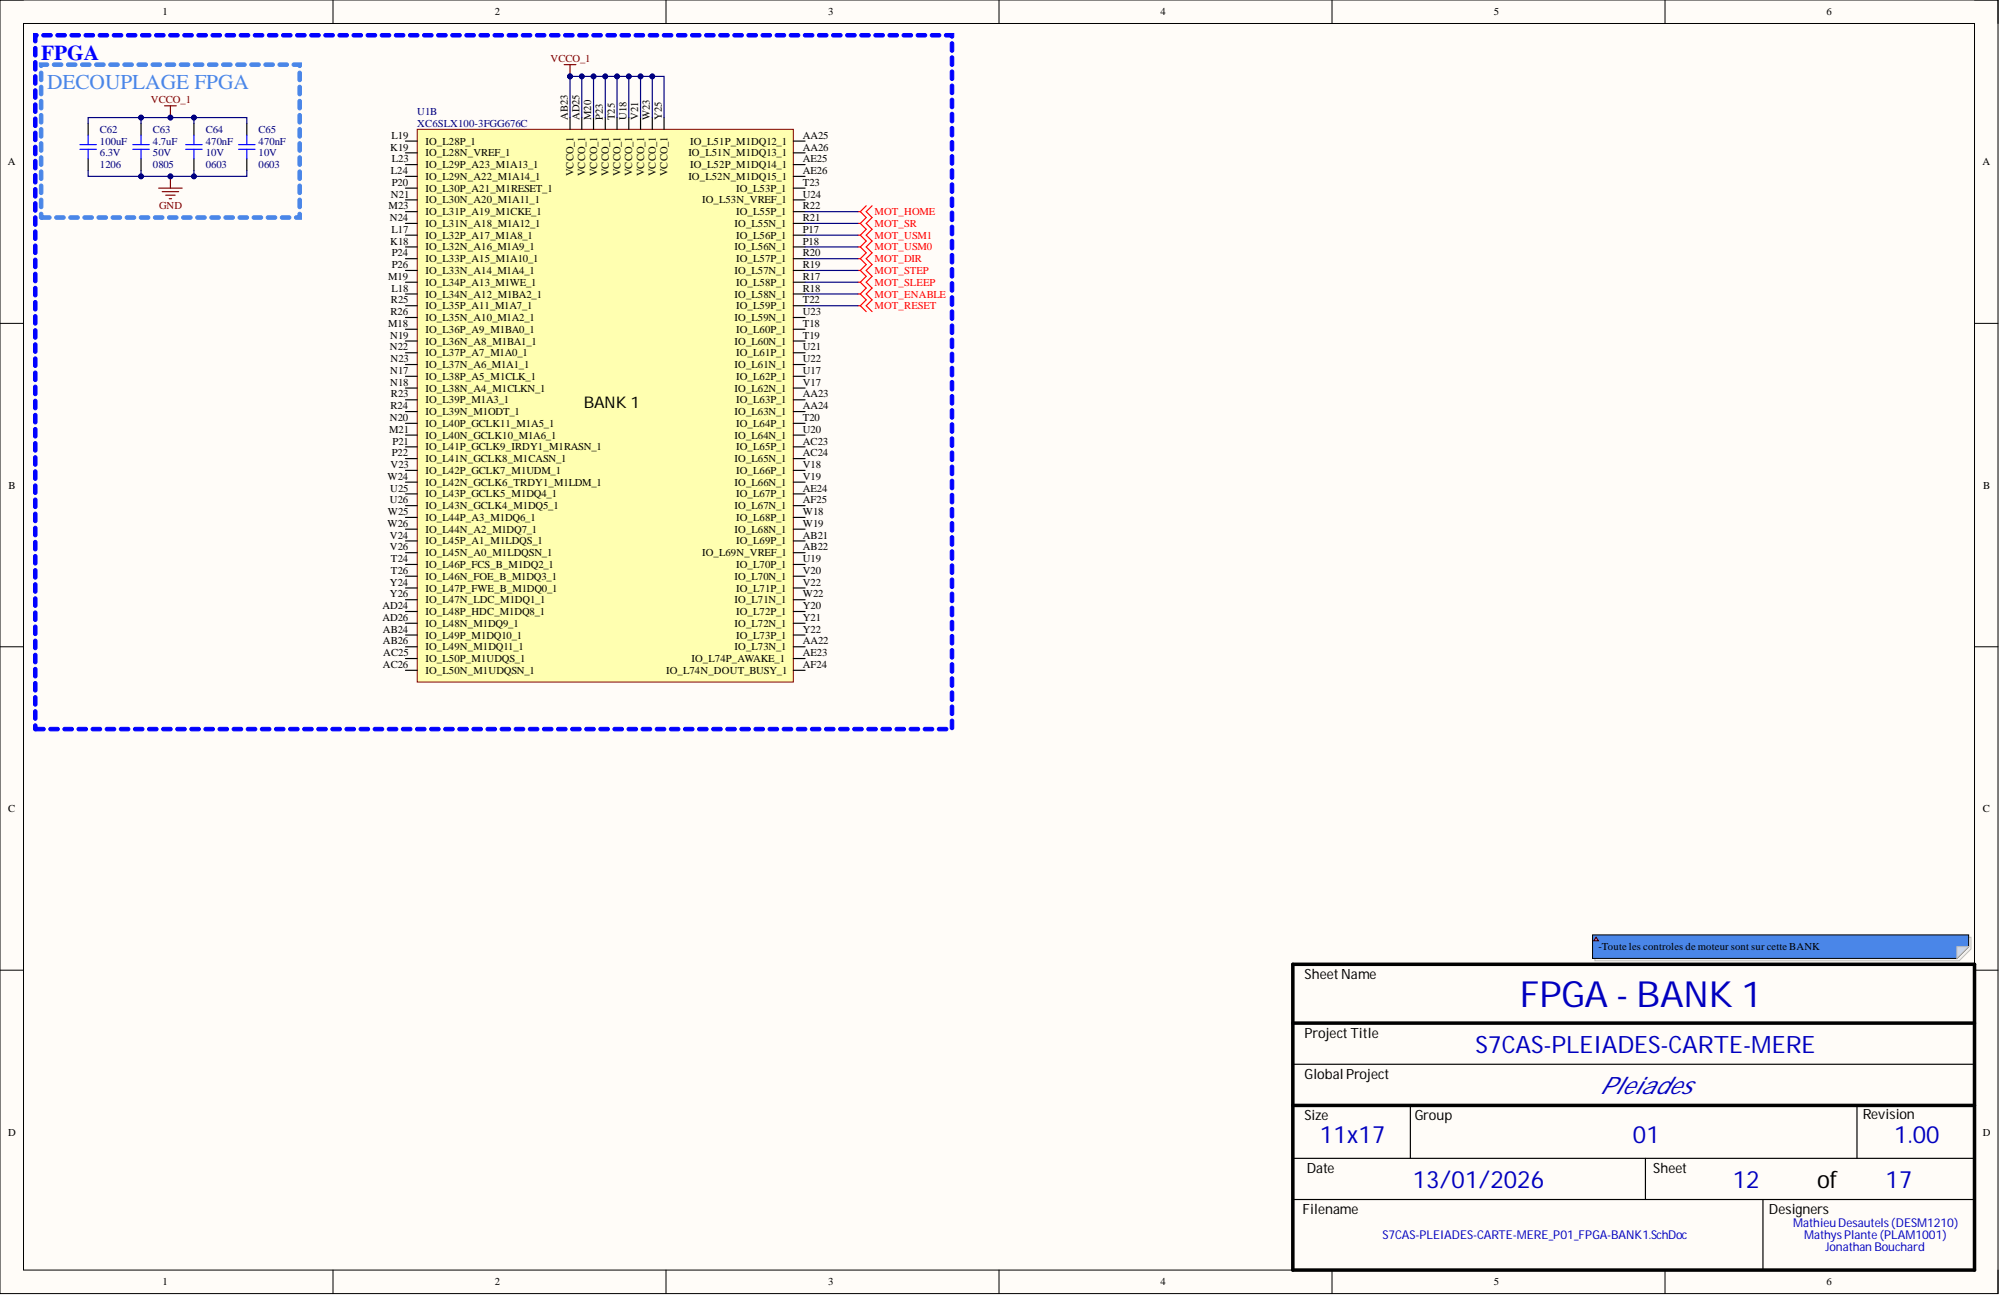
[picture p12: page 12]

Siz e 11x17 | Group 01 | R evisio n 1.00

Da te 13/01/2026 | She e t 12 of 17

TE-MERE_P01_F PGA-BANK1.

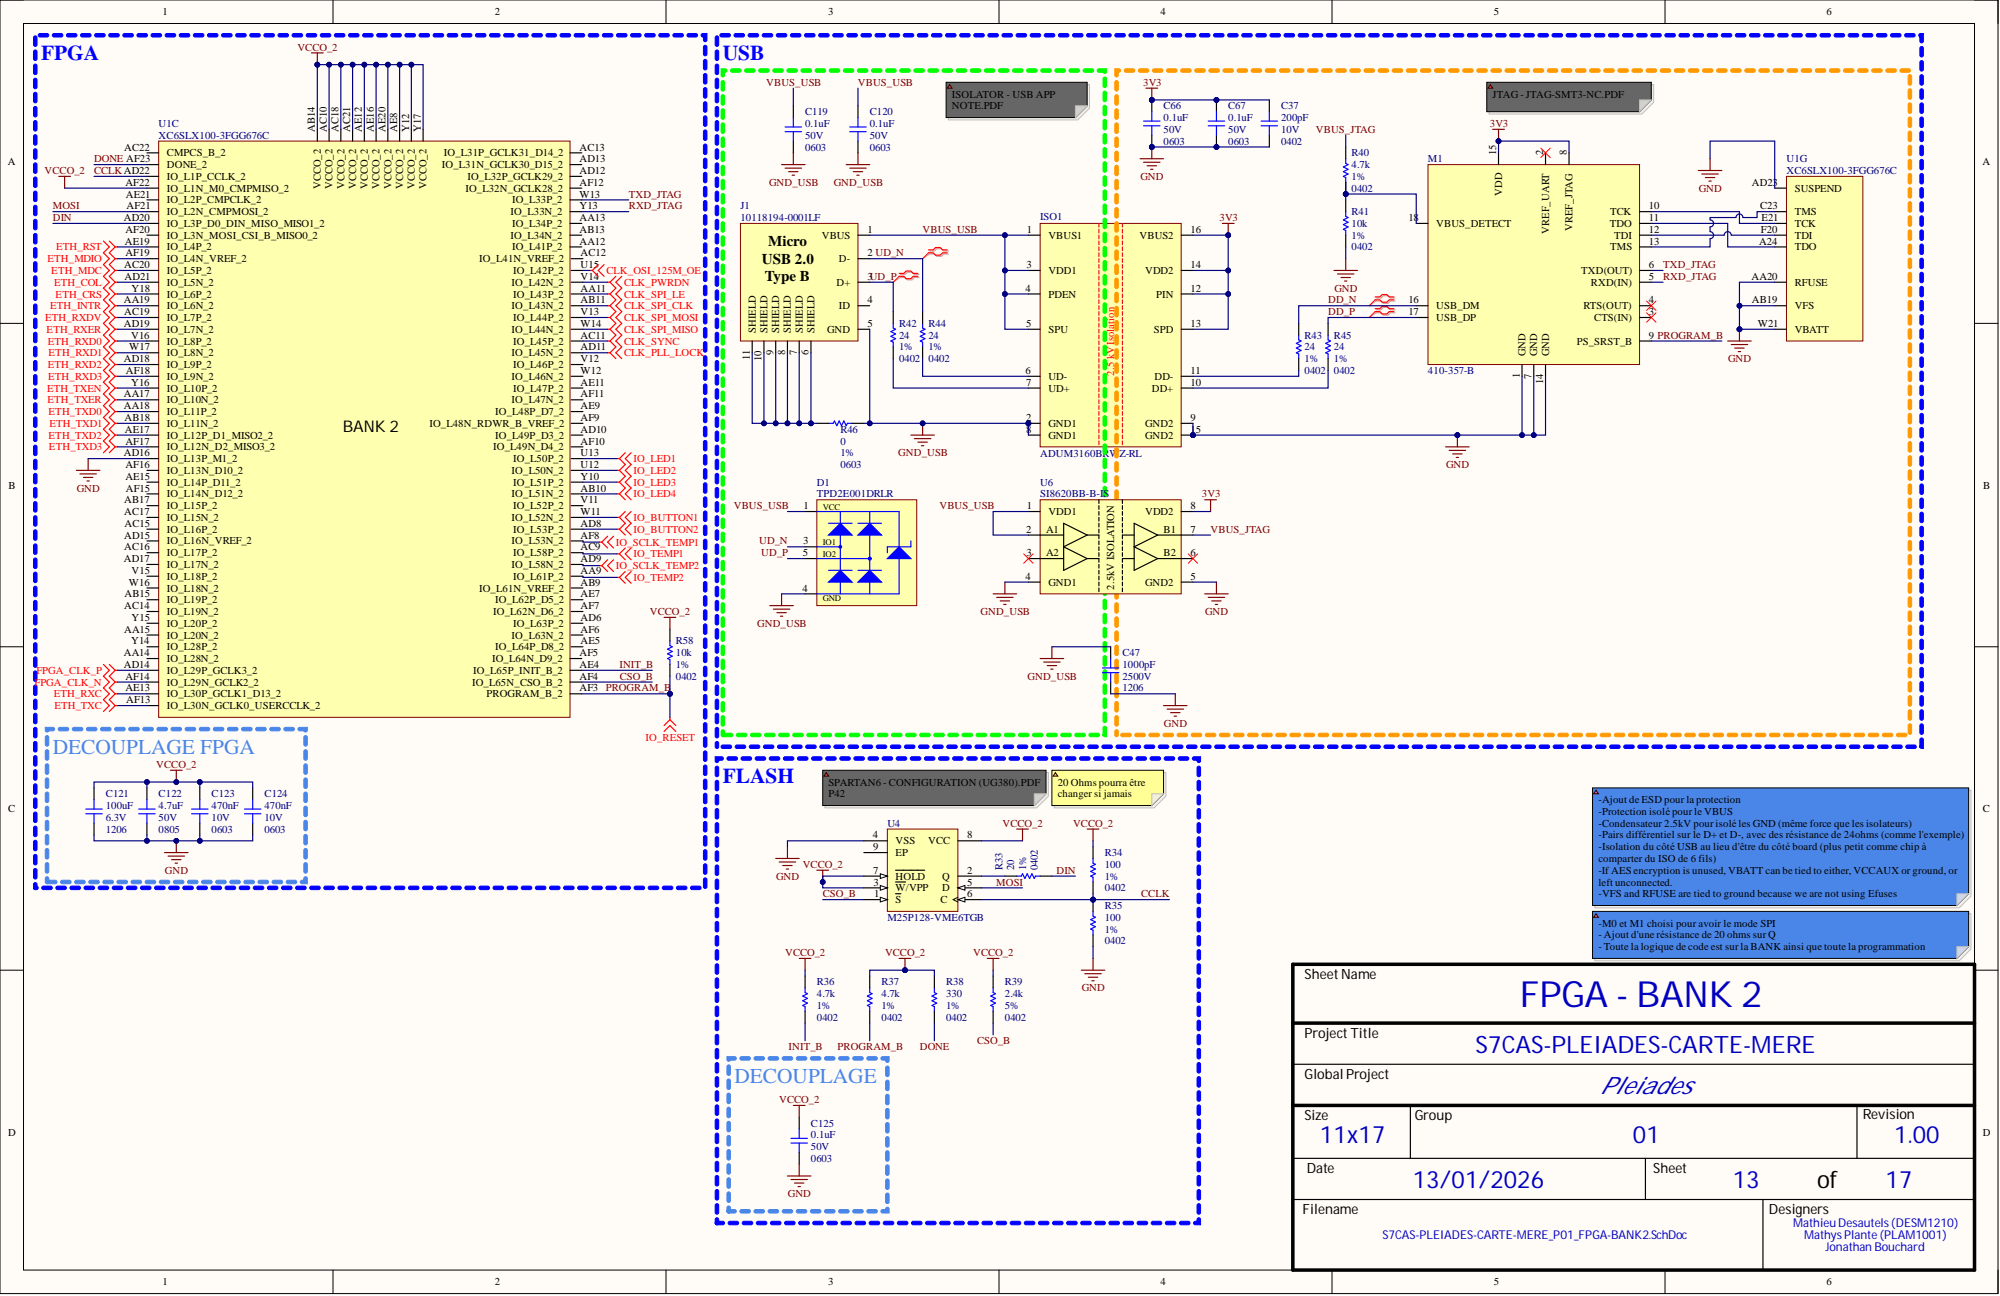
[picture p13: page 13]

SHIELD 6 SHIELD 7 SHIELD 8 SHIELD 9 SHIELD 10 SHIELD 11

Siz e 11x17 | Group 01 | R evisio n 1.00

Da te 13/01/2026 | She e t 13 of 17

TE-MERE_P01_F PGA-BANK2.

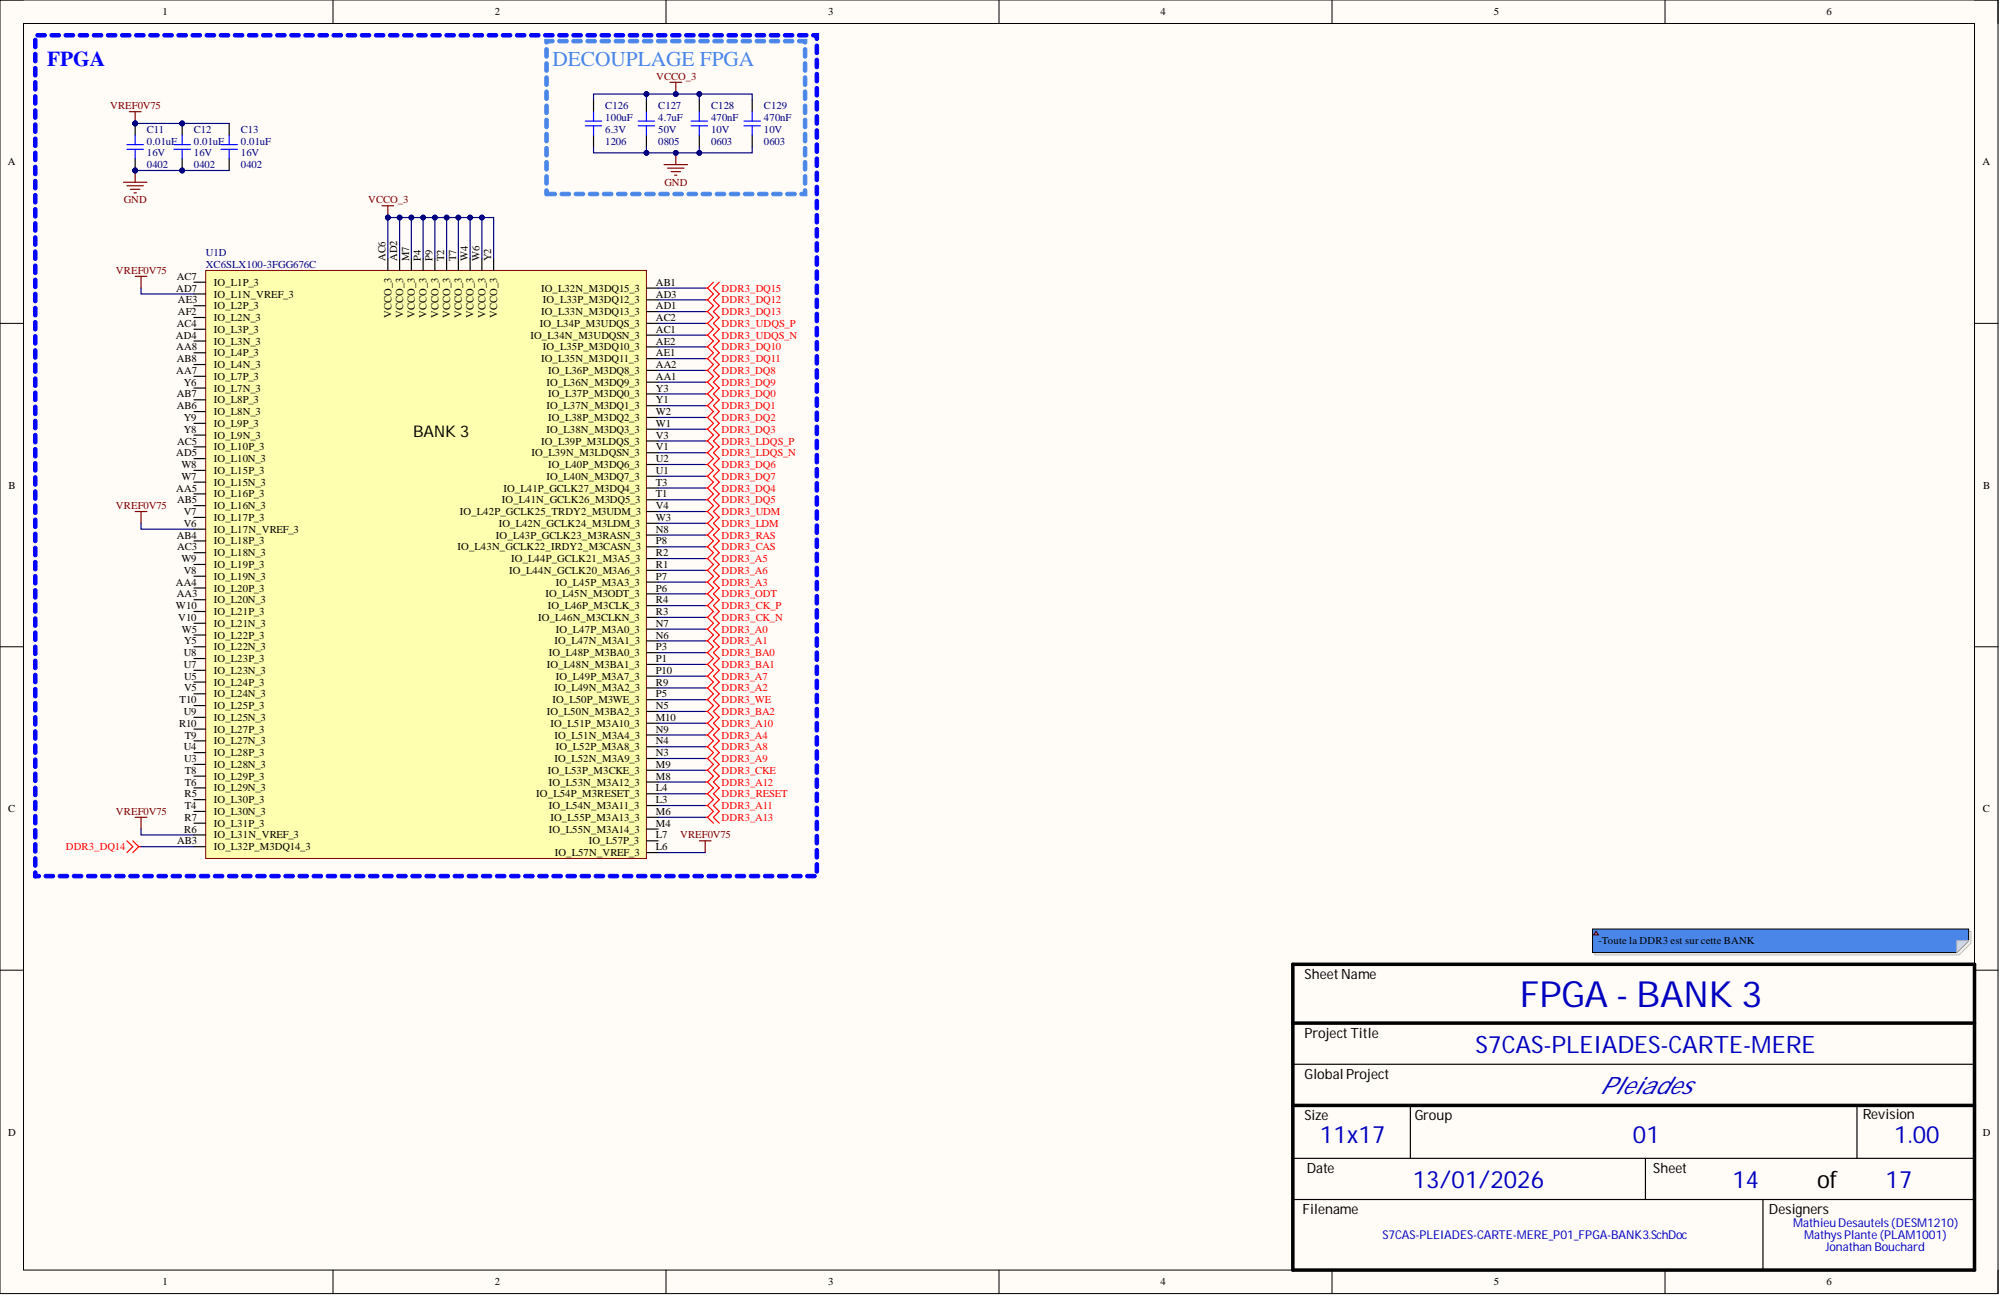
[picture p14: page 14]

Siz e 11x17 | Group 01 | R evisio n 1.00

Da te 13/01/2026 | She e t 14 of 17

TE-MERE_P01_F PGA-BANK3.

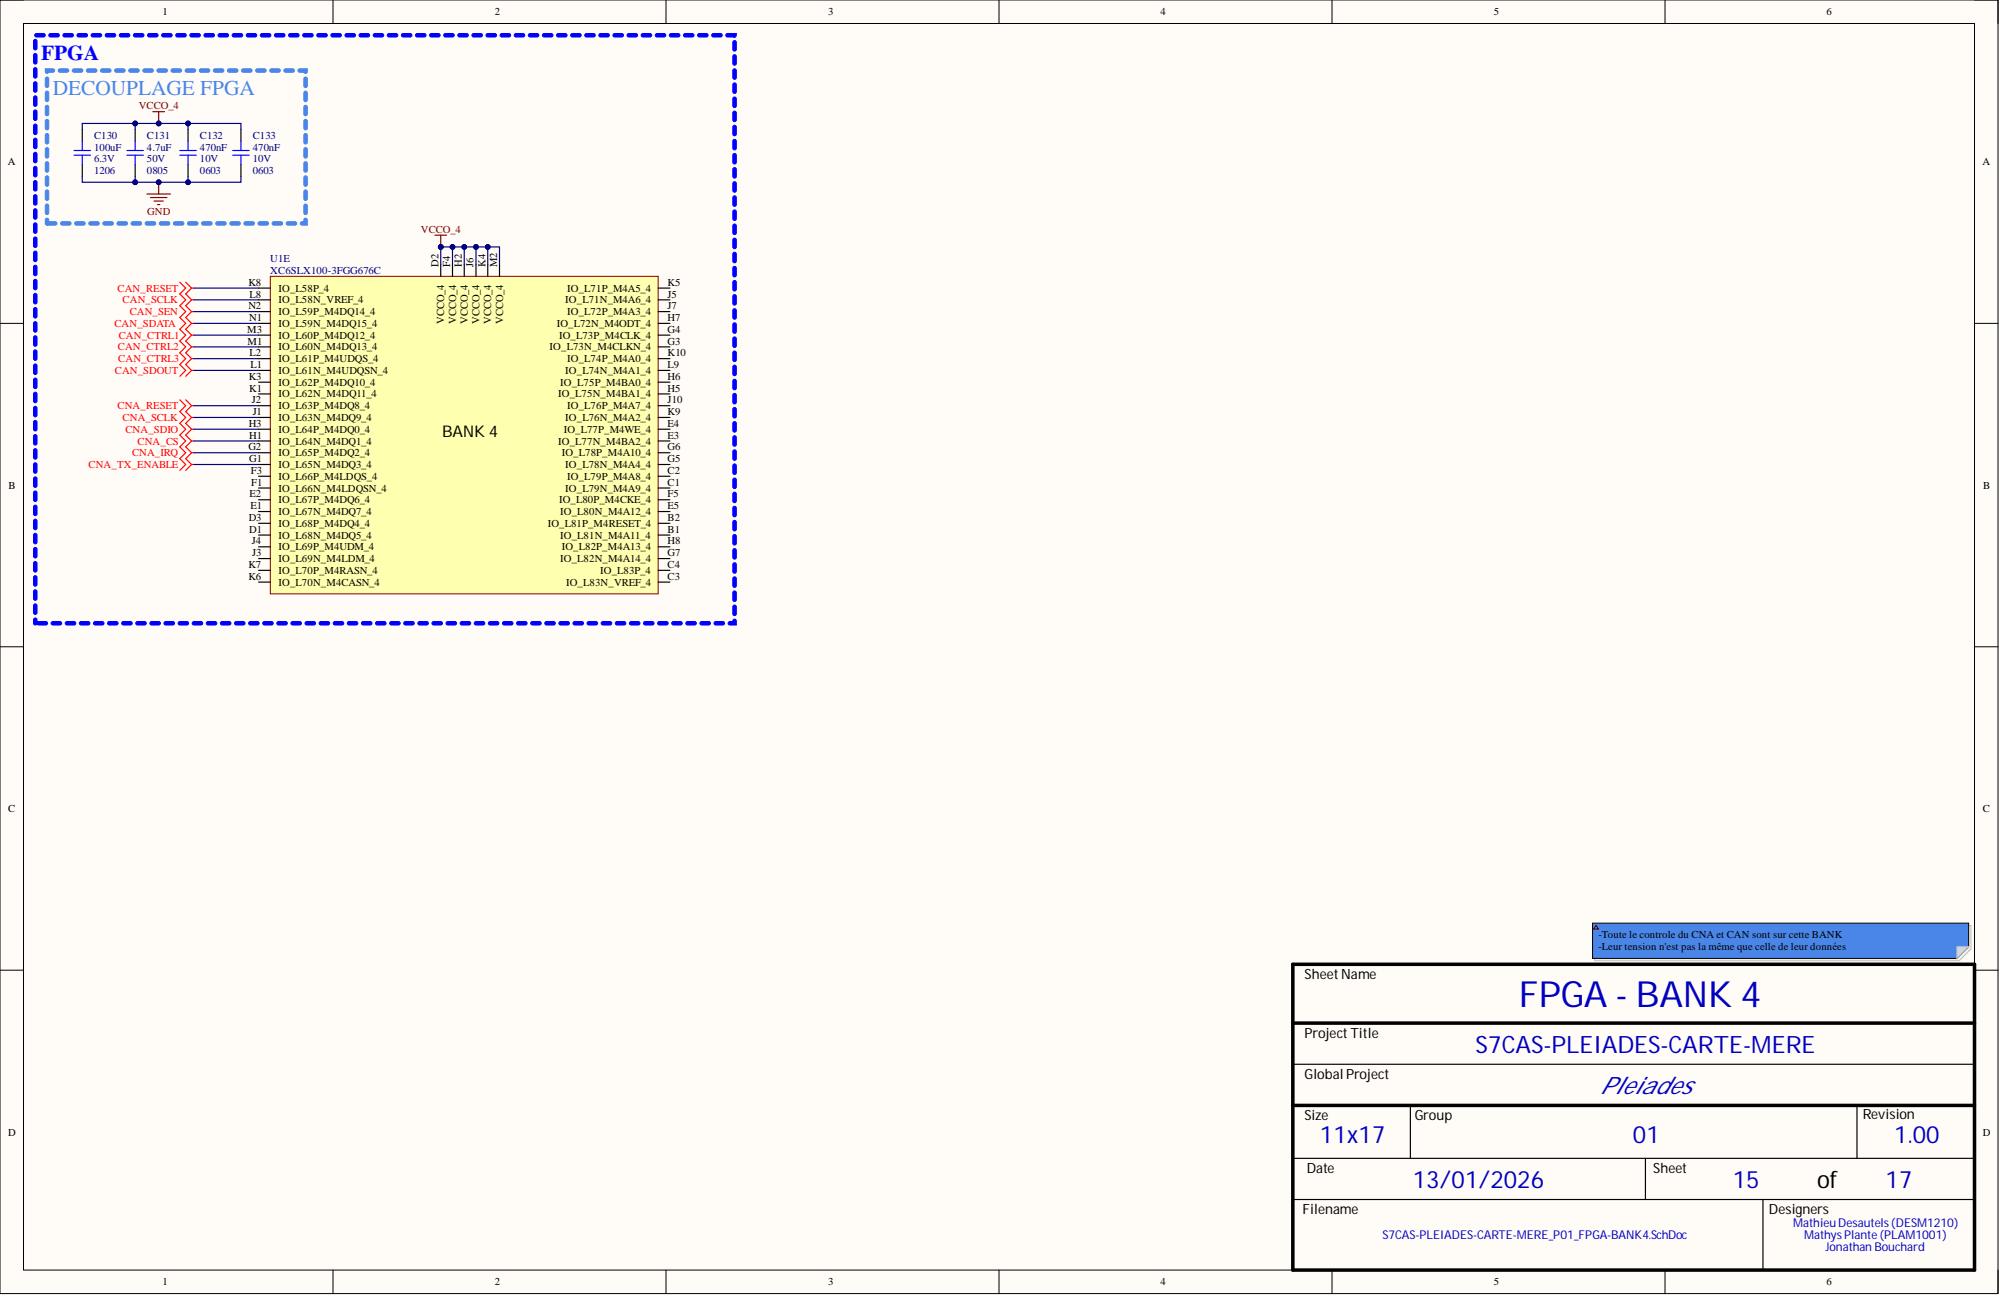
[picture p15: page 15]

Siz e 11x17 | Group 01 | R evisio n 1.00

Da te 13/01/2026 | She e t 15 of 17

TE-MERE_P01_F PGA-BANK4.

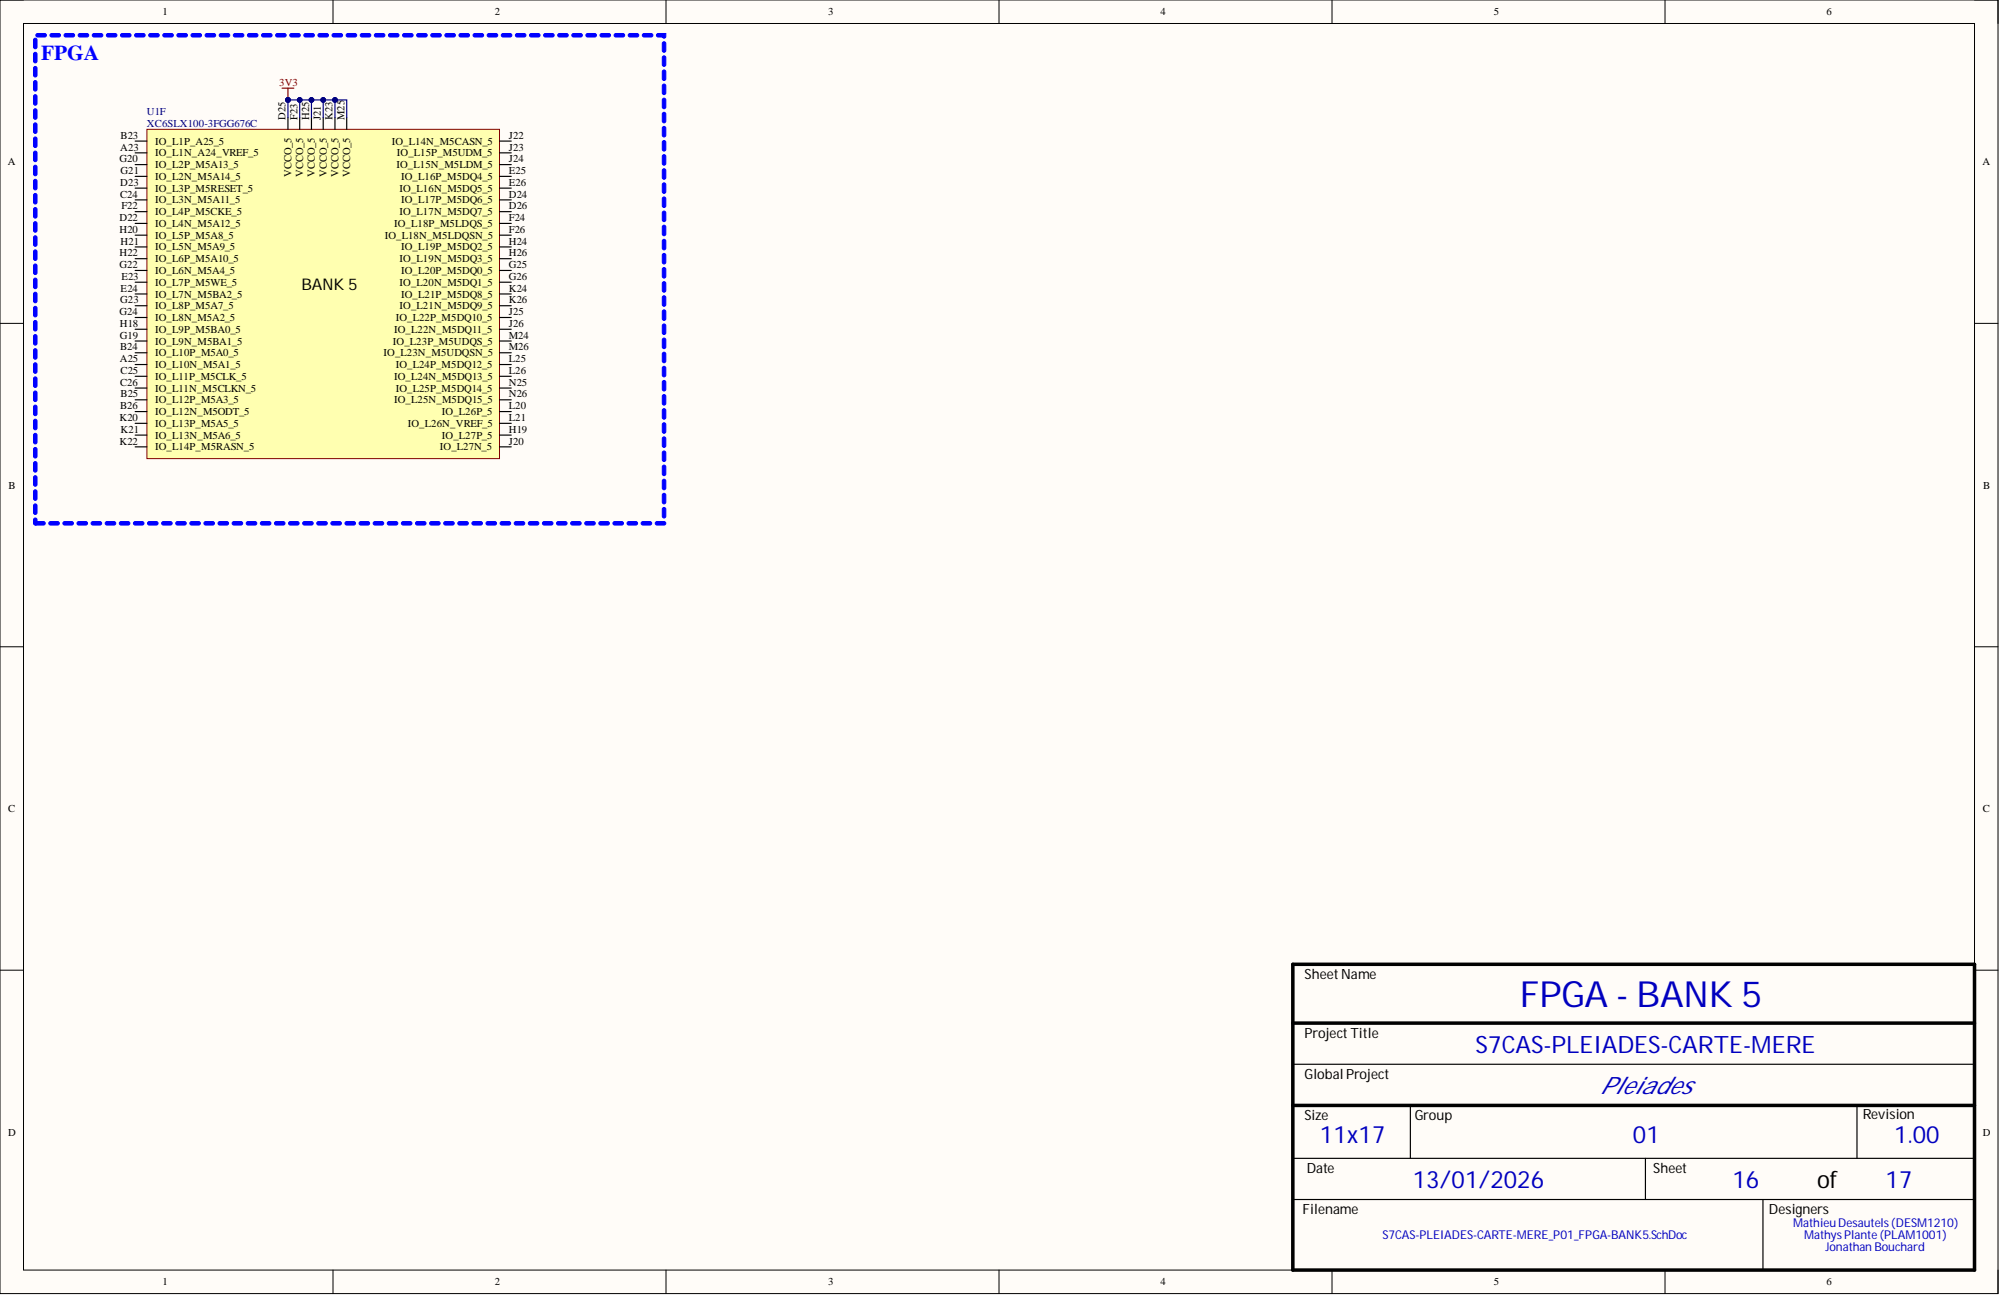
[picture p16: page 16]

Siz e 11x17 | Group 01 | R evisio n 1.00

Da te 13/01/2026 | She e t 16 of 17

TE-MERE_P01_F PGA-BANK5.

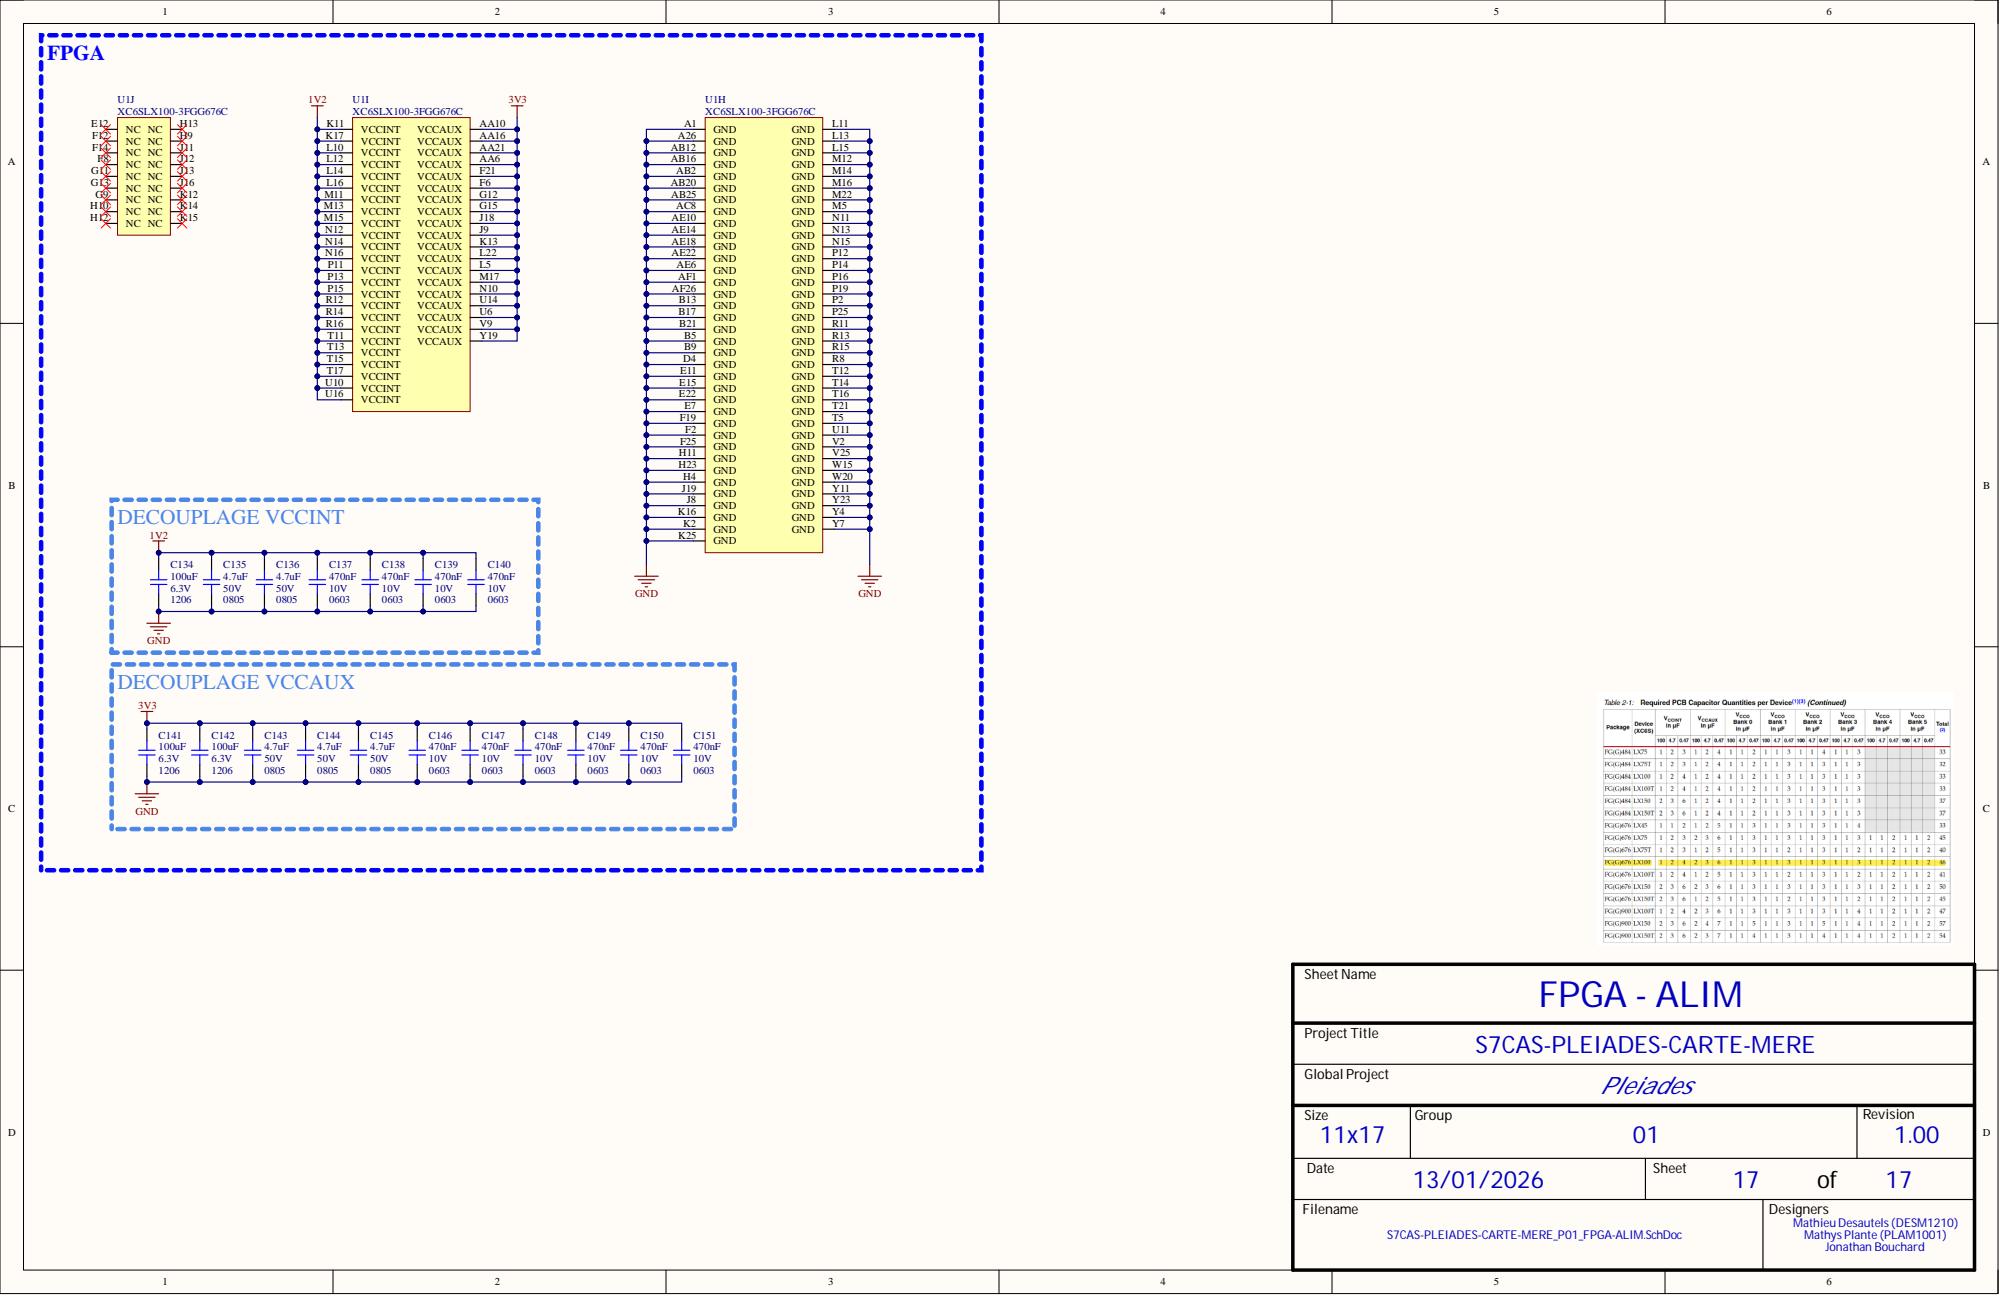
[picture p17: page 17]

Size 11x17 | Group 01 | Revision 1.00

Date 13/01/2026 | Sheet 17 of 17

S7CAS-PLEIADES-CARTE-MERE_P01_FPGA-ALIM.SchDoc | Mathieu Desautels (DESM1210)
