Mat-desau/S7_APP1/(list of files, drawings)

Other design files:
APP/01 - SCHEMAS ET PCB/98 - TEMP LIBRARY/LIB_TEMP_P01_DESM1210_PCB.PcbLib
APP/01 - SCHEMAS ET PCB/98 - TEMP LIBRARY/LIB_TEMP_P01_DESM1210_SCH.SchLib
APP/01 - SCHEMAS ET PCB/99 - WORKING COPY/HeatSink_PCB.PcbLib
APP/01 - SCHEMAS ET PCB/99 - WORKING COPY/HeatSink_SCH.SchLib
APP/01 - SCHEMAS ET PCB/99 - WORKING COPY/S7CAS-PLEIADES-CARTE-MERE_P01.PcbDoc
APP/01 - SCHEMAS ET PCB/99 - WORKING COPY/S7CAS-PLEIADES-CARTE-MERE_P01.PrjPcb
APP/01 - SCHEMAS ET PCB/99 - WORKING COPY/S7CAS-PLEIADES-CARTE-MERE_P01_ALIM.SchDoc
APP/01 - SCHEMAS ET PCB/99 - WORKING COPY/S7CAS-PLEIADES-CARTE-MERE_P01_CAN.SchDoc
APP/01 - SCHEMAS ET PCB/99 - WORKING COPY/S7CAS-PLEIADES-CARTE-MERE_P01_CLOCK.SchDoc
APP/01 - SCHEMAS ET PCB/99 - WORKING COPY/S7CAS-PLEIADES-CARTE-MERE_P01_CNA.SchDoc
APP/01 - SCHEMAS ET PCB/99 - WORKING COPY/S7CAS-PLEIADES-CARTE-MERE_P01_DDR3.SchDoc
APP/01 - SCHEMAS ET PCB/99 - WORKING COPY/S7CAS-PLEIADES-CARTE-MERE_P01_ETHERNET.SchDoc
APP/01 - SCHEMAS ET PCB/99 - WORKING COPY/S7CAS-PLEIADES-CARTE-MERE_P01_FPGA-ALIM.SchDoc
APP/01 - SCHEMAS ET PCB/99 - WORKING COPY/S7CAS-PLEIADES-CARTE-MERE_P01_FPGA-BANK0.SchDoc
APP/01 - SCHEMAS ET PCB/99 - WORKING COPY/S7CAS-PLEIADES-CARTE-MERE_P01_FPGA-BANK1.SchDoc
APP/01 - SCHEMAS ET PCB/99 - WORKING COPY/S7CAS-PLEIADES-CARTE-MERE_P01_FPGA-BANK2.SchDoc
APP/01 - SCHEMAS ET PCB/99 - WORKING COPY/S7CAS-PLEIADES-CARTE-MERE_P01_FPGA-BANK3.SchDoc
APP/01 - SCHEMAS ET PCB/99 - WORKING COPY/S7CAS-PLEIADES-CARTE-MERE_P01_FPGA-BANK4.SchDoc
APP/01 - SCHEMAS ET PCB/99 - WORKING COPY/S7CAS-PLEIADES-CARTE-MERE_P01_FPGA-BANK5.SchDoc
APP/01 - SCHEMAS ET PCB/99 - WORKING COPY/S7CAS-PLEIADES-CARTE-MERE_P01_IO.SchDoc
APP/01 - SCHEMAS ET PCB/99 - WORKING COPY/S7CAS-PLEIADES-CARTE-MERE_P01_MOTORS.SchDoc
APP/01 - SCHEMAS ET PCB/99 - WORKING COPY/S7CAS-PLEIADES-CARTE-MERE_P01_POWER.SchDoc
APP/01 - SCHEMAS ET PCB/99 - WORKING COPY/S7CAS-PLEIADES-CARTE-MERE_P01_TITLE.SchDoc
APP/01 - SCHEMAS ET PCB/99 - WORKING COPY/s7cas_lib2023/S7CAS_LIB2023.PcbLib
APP/01 - SCHEMAS ET PCB/99 - WORKING COPY/s7cas_lib2023/S7CAS_LIB2023.SchLib
APP/01 - SCHEMAS ET PCB/S7CAS-PLEIADES-CARTE-MERE_P01.PcbDoc
APP/01 - SCHEMAS ET PCB/S7CAS-PLEIADES-CARTE-MERE_P01.PrjPcb
