Mat-desau/S7_APP1/(commit log)

2026-01-14 Ajout de pas mal de stock
    [APP1_PLAM1001_DESM1210.PrjPcb, LIB_TEMP_P01_DESM1210_PCB.PcbLib, LIB_TEMP_P01_DESM1210_SCH.SchLib, S7CAS-PLEIADES-CARTE-MERE_P01.PcbDoc, S7CAS-PLEIADES-CARTE-MERE_P01.PrjPcb, S7CAS-PLEIADES-CARTE-MERE_P01_ALIM.SchDoc, S7CAS-PLEIADES-CARTE-MERE_P01_ASIC.SchDoc, S7CAS-PLEIADES-CARTE-MERE_P01_CONNECTORS.SchDoc]
2026-01-20 Ajout de choses avancement
    [S7CAS-PLEIADES-CARTE-MERE_P01.PcbDoc, S7CAS-PLEIADES-CARTE-MERE_P01.PrjPcb, S7CAS-PLEIADES-CARTE-MERE_P01_ALIM.SchDoc, S7CAS-PLEIADES-CARTE-MERE_P01_DDR3.SchDoc, S7CAS-PLEIADES-CARTE-MERE_P01_ETHERNET.SchDoc, S7CAS-PLEIADES-CARTE-MERE_P01_FPGA-ALIM.SchDoc, S7CAS-PLEIADES-CARTE-MERE_P01_FPGA-BANK0.SchDoc, S7CAS-PLEIADES-CARTE-MERE_P01_FPGA-BANK1.SchDoc]
2026-01-23 Enlever les logs
2026-01-29 Ajout pour le minou
    [Arbre de puissance.xlsx, S7CAS-PLEIADES-CARTE-MERE_P01.PcbDoc, S7CAS-PLEIADES-CARTE-MERE_P01_ALIM.SchDoc, S7CAS-PLEIADES-CARTE-MERE_P01_CAN.SchDoc, S7CAS-PLEIADES-CARTE-MERE_P01_CLOCK.SchDoc, S7CAS-PLEIADES-CARTE-MERE_P01_CNA.SchDoc, S7CAS-PLEIADES-CARTE-MERE_P01_DDR3.SchDoc, S7CAS-PLEIADES-CARTE-MERE_P01_ETHERNET.SchDoc]
2026-02-11 Derniere modifications
    [S7CAS-PLEIADES-CARTE-MERE_P01_ALIM.SchDoc, S7CAS-PLEIADES-CARTE-MERE_P01_CLOCK.SchDoc, S7CAS-PLEIADES-CARTE-MERE_P01_DDR3.SchDoc, S7CAS-PLEIADES-CARTE-MERE_P01_IO.SchDoc, S7CAS-PLEIADES-CARTE-MERE_P01_MOTORS.SchDoc, S7CAS_LIB2023.PcbLib, S7CAS_LIB2023.SchLib]
2026-02-11 Test 2
    [S7CAS-PLEIADES-CARTE-MERE_P01_POWER.SchDoc]
2026-02-11 test 3
    [S7CAS-PLEIADES-CARTE-MERE_P01_POWER.SchDoc]
2026-02-11 Avec git ignore
    [S7CAS-PLEIADES-CARTE-MERE_P01_POWER.SchDoc]
2026-02-11 Test finale
    [S7CAS-PLEIADES-CARTE-MERE_P01_POWER.SchDoc]
2026-02-11 Correction schéma avant APP2
    [S7CAS-PLEIADES-CARTE-MERE_P01.PrjPcb, S7CAS-PLEIADES-CARTE-MERE_P01_CAN.SchDoc, S7CAS-PLEIADES-CARTE-MERE_P01_CNA.SchDoc, S7CAS-PLEIADES-CARTE-MERE_P01_DDR3.SchDoc, S7CAS-PLEIADES-CARTE-MERE_P01_ETHERNET.SchDoc, S7CAS-PLEIADES-CARTE-MERE_P01_MOTORS.SchDoc]
2026-02-11 Modif ensemble
    [S7CAS-PLEIADES-CARTE-MERE_P01.PcbDoc, S7CAS-PLEIADES-CARTE-MERE_P01.PrjPcb]
2026-02-11 DERNIERE MODIFICATIONS DE PCB - TOUTE PLACER EN SECTIONS
    [S7CAS-PLEIADES-CARTE-MERE_P01.PcbDoc, S7CAS-PLEIADES-CARTE-MERE_P01.PrjPcb]
2026-02-16 Commencer a checker le PCB
    [S7CAS-PLEIADES-CARTE-MERE_P01.PcbDoc, S7CAS-PLEIADES-CARTE-MERE_P01.PrjPcb, S7CAS-PLEIADES-CARTE-MERE_P01_ALIM.SchDoc, S7CAS-PLEIADES-CARTE-MERE_P01_FPGA-BANK2.SchDoc]
2026-02-18 Ajout de toute le PCB
    [S7CAS-PLEIADES-CARTE-MERE_P01.PcbDoc, S7CAS-PLEIADES-CARTE-MERE_P01.PrjPcb]
2026-02-19 Vraiment beaucoup de modif d'avancement
    [S7CAS-PLEIADES-CARTE-MERE_P01.PcbDoc, S7CAS-PLEIADES-CARTE-MERE_P01_ETHERNET.SchDoc]
2026-02-25 Ajout de chose
    [S7CAS-PLEIADES-CARTE-MERE_P01.PcbDoc, S7CAS-PLEIADES-CARTE-MERE_P01.PrjPcb, S7CAS-PLEIADES-CARTE-MERE_P01_CAN.SchDoc, S7CAS-PLEIADES-CARTE-MERE_P01_CNA.SchDoc, S7CAS-PLEIADES-CARTE-MERE_P01_ETHERNET.SchDoc, S7CAS-PLEIADES-CARTE-MERE_P01_FPGA-BANK2.SchDoc]
2026-02-26 Ajout PDF
    [S7CAS-PLEIADES-CARTE-MERE_P01.PcbDoc, S7CAS-PLEIADES-CARTE-MERE_P01_CAN.SchDoc, S7CAS-PLEIADES-CARTE-MERE_P01_CNA.SchDoc, S7CAS-PLEIADES-CARTE-MERE_P01_TITLE.SchDoc]
2026-03-10 Ajout de choses
    [HeatSink_PCB.PcbLib, HeatSink_SCH.SchLib, S7CAS-PLEIADES-CARTE-MERE_P01.PcbDoc, S7CAS-PLEIADES-CARTE-MERE_P01.PrjPcb, S7CAS-PLEIADES-CARTE-MERE_P01_FPGA-ALIM.SchDoc, S7CAS-PLEIADES-CARTE-MERE_P01_TITLE.SchDoc, S7CAS_LIB2023.PcbLib, S7CAS_LIB2023.SchLib]
2026-03-10 Ca sent la fin
    [HeatSink_PCB.PcbLib, HeatSink_SCH.SchLib, S7CAS-PLEIADES-CARTE-MERE_P01.PcbDoc, S7CAS-PLEIADES-CARTE-MERE_P01_FPGA-ALIM.SchDoc]
2026-04-20 Effacer fichier innutile
    [S7CAS-PLEIADES-CARTE-MERE_P01.GBL, S7CAS-PLEIADES-CARTE-MERE_P01.GBO, S7CAS-PLEIADES-CARTE-MERE_P01.GBP, S7CAS-PLEIADES-CARTE-MERE_P01.GBS, S7CAS-PLEIADES-CARTE-MERE_P01.GTL, S7CAS-PLEIADES-CARTE-MERE_P01.GTO, S7CAS-PLEIADES-CARTE-MERE_P01.GTP, S7CAS-PLEIADES-CARTE-MERE_P01.GTS]
